Darksplat/solar-rainwater-tank-monitor/hardware/pcb/README.md

# PCB release hold

No valid complete schematic, layout, Gerber, drill, CPL or board 3D file exists in this revision. Directories reserve the requested structure. Do not mistake their presence for deliverables.

KiCad CLI 10.0.3 is installed. Live IPC was unavailable. This does not itself prevent offline design; current blockers are incomplete protected input/power design, final component qualification and footprint verification. Do not export an outline-only board and claim it is manufacturable.

Next: select protected receiver and power converters, obtain sensor order drawing, assign every pin/net, complete loop and power fault analysis, create manufacturer-backed symbol/footprint library, draw schematic, run ERC, route layout with antenna keepout, run DRC/unconnected checks, then export fabrication and assembly package and prototype.
