Darksplat/solar-rainwater-tank-monitor/releases/0.1.0-dev/README.md

**HISTORICAL: incompatible with revision0.2 INA228 hardware. Do not deploy these images on the new board.**

# 0.1.0-dev compilation fixtures

DO NOT DEPLOY: these binaries contain public test API keys and a public example Thread dataset. They prove device compilation only. Rebuild from source using independent private credentials and the reviewed production hardware design. No physical hardware testing has been performed.

Hashes and compiler evidence: ../../tests/test-results/build-summary.json. Development source revision and hosted test evidence are recorded in docs/publication-validation.md. The local v0.1.0-dev tag has not been published to GitHub.
