Darksplat/solar-rainwater-tank-monitor/docs/project-overview.md

# Architecture and engineering boundaries

Each of two identical nodes has its own panel, controller, protected 4S LiFePO4 pack and fused load feed. Neither node supplies the other. Preferred radio is ESP32-C6 Thread MTD with 5 s polling; the design does not credit unmeasured processor sleep savings. Thread transports the ESPHome native API, not Matter.

Two series 20 W panels feed a SmartSolar 75/10 through a reverse-blocking diode and 20 mΩ PV shunt. The PV return remains separate from battery negative externally. A fused 20 Ah LiFePO4 battery connects through back-to-back reverse-protection MOSFETs and a 10 mΩ battery shunt to the charger and Smart BatteryProtect input. BatteryProtect OUT powers the custom PCB; charger LOAD terminals are unused. The buck supplies 3.3 V to ESP32-C6-MINI-1 and three INA228 monitors. A switched boost supplies nominal 17.2 V to the pressure loop through a 2 Ω measurement shunt and two 110 Ω limiting resistors.

Battery percentage uses signed hardware charge accumulation after an explicit verified-full reference. It becomes unavailable after reboot, invalid samples, counter reset or capacity change; voltage alone is never treated as LiFePO4 SOC. Solar panel voltage/current/power and net battery current distinguish generation from charging. Unknown readings remain unknown.

Tank geometry inputs: length, width, usable depth, diaphragm elevation, rated capacity and maximum operating level (floor datum). Usable depth must not exceed operating level. Usable volume means water above the configured unusable bottom layer. Also report total contained water separately when calibrated. Pressure cannot resolve water below the diaphragm; mark this blind region rather than inventing a depth. Manufacturer method uses verified total volume at a measured reference depth, never the unverified 10,000 L label.

The owner's Kingspan catalogue tank is 4.0 m long, 1.15 m wide and 2.32 m high; the original 4 m height assumption is superseded. Internal rounded geometry, outlet and diaphragm datums and actual maximum fill remain unverified. Firmware uses a configurable pressure span (40 kPa default), rounded-rectangle geometry or verified volume/reference-depth calibration; calibration remains disabled until measurements are entered. Both tanks supply the garden and one also provides fire water. The owner requests no minimum-reserve display. Preserve the existing Raspberry Pi Zero2W/PoE/Sonoff Thread border router. See site-configuration.md for provenance and provisional settings. Do not drill the tank.
