Darksplat/solar-rainwater-tank-monitor/hardware/pcb/layout/render/tank-monitor-bottom.png

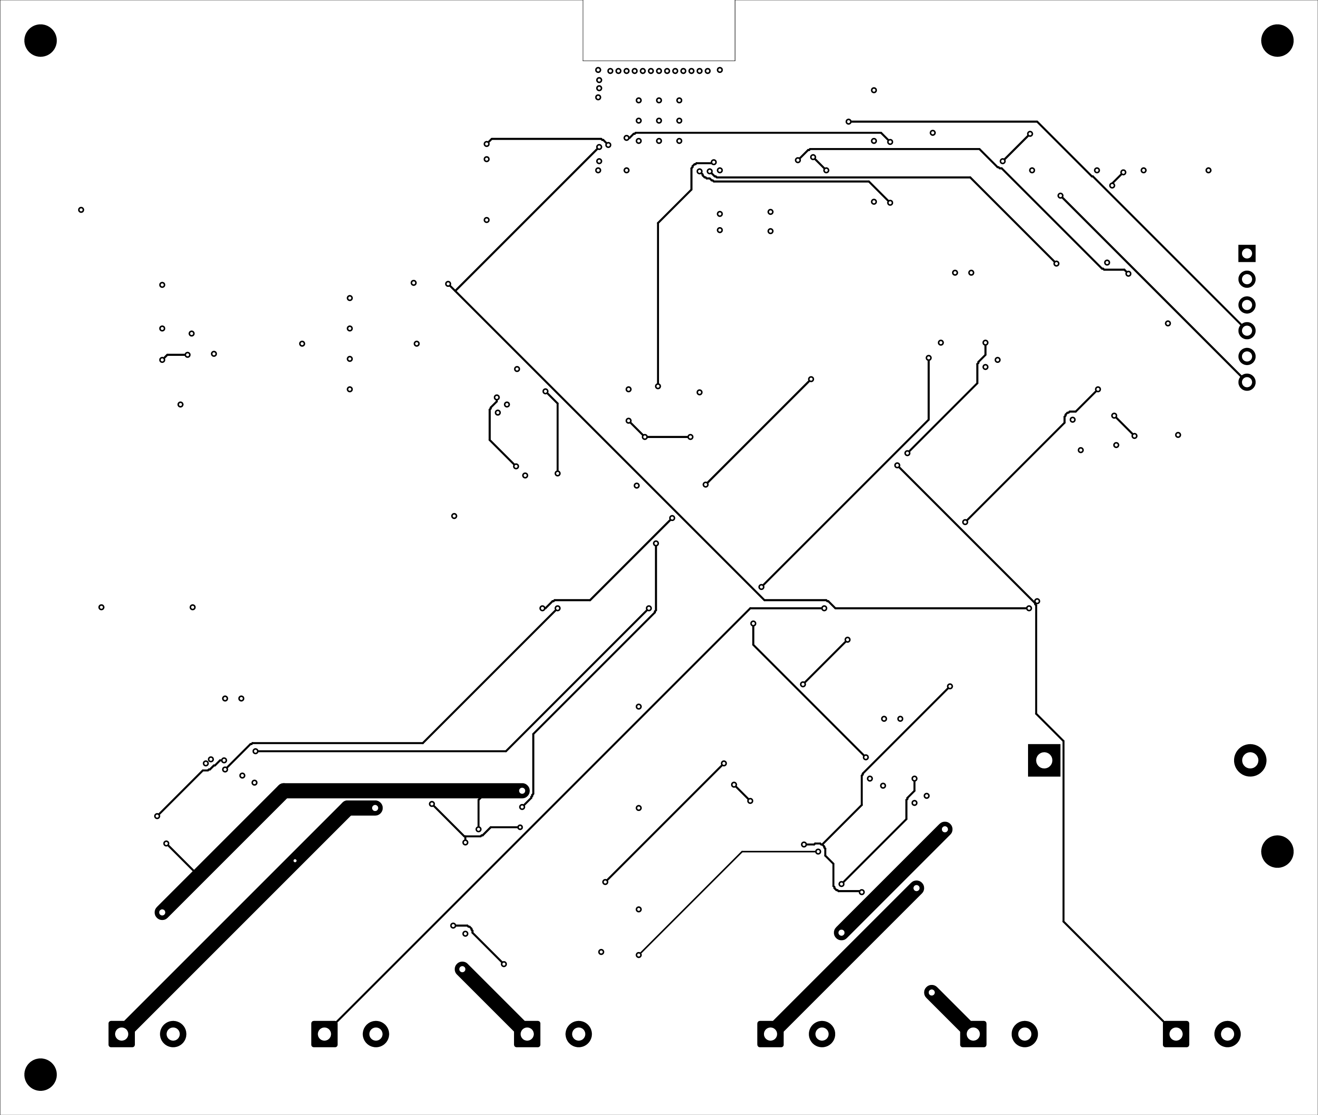
hardware/pcb/layout/render/tank-monitor-bottom.png
