Darksplat/solar-rainwater-tank-monitor/hardware/pcb/layout/render/tank-monitor-top.png

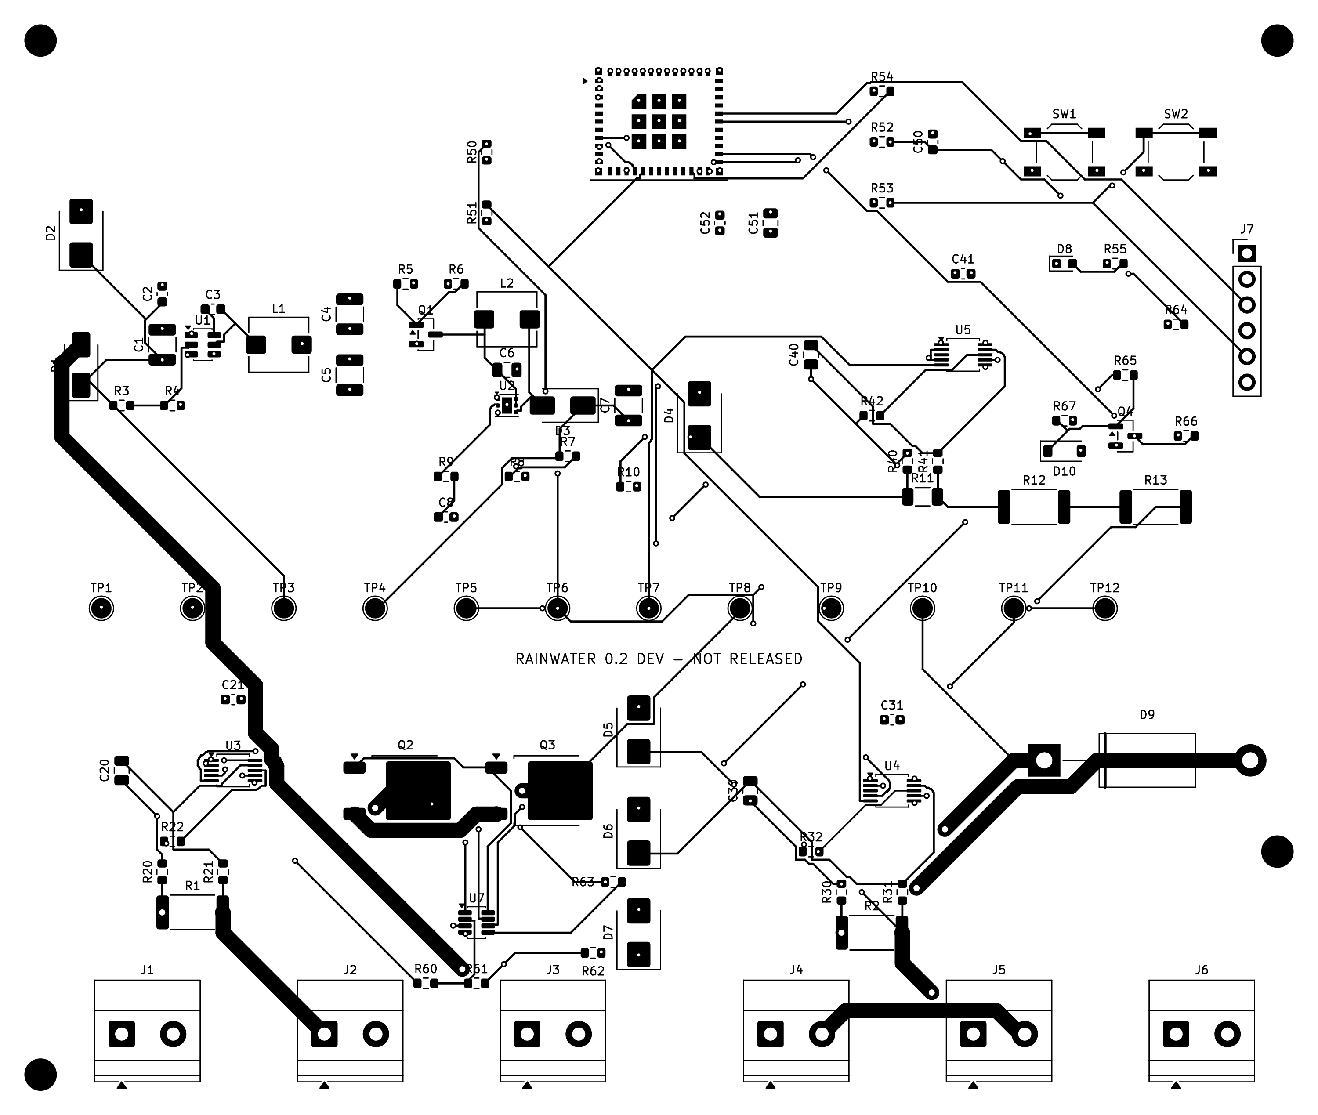
hardware/pcb/layout/render/tank-monitor-top.png
