Darksplat/solar-rainwater-tank-monitor/hardware/pcb/schematic/render/tank-monitor.png

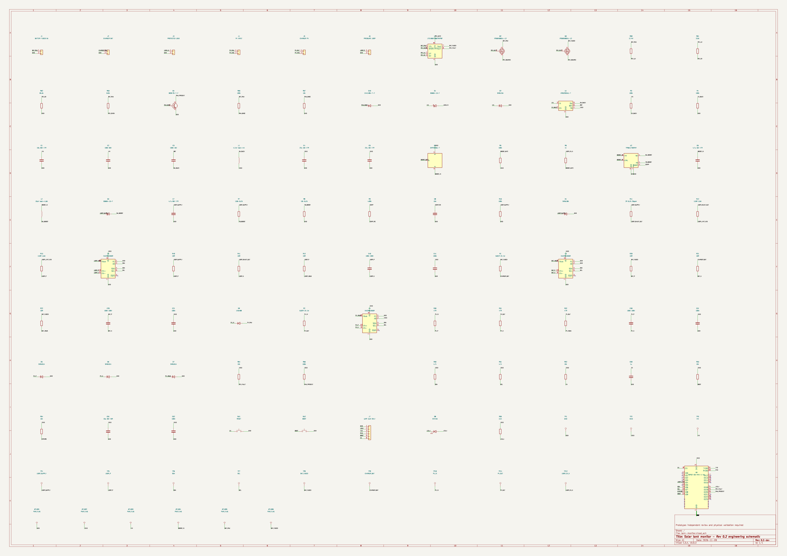
hardware/pcb/schematic/render/tank-monitor.png
