Darksplat/solar-rainwater-tank-monitor/hardware/wiring/architecture.png

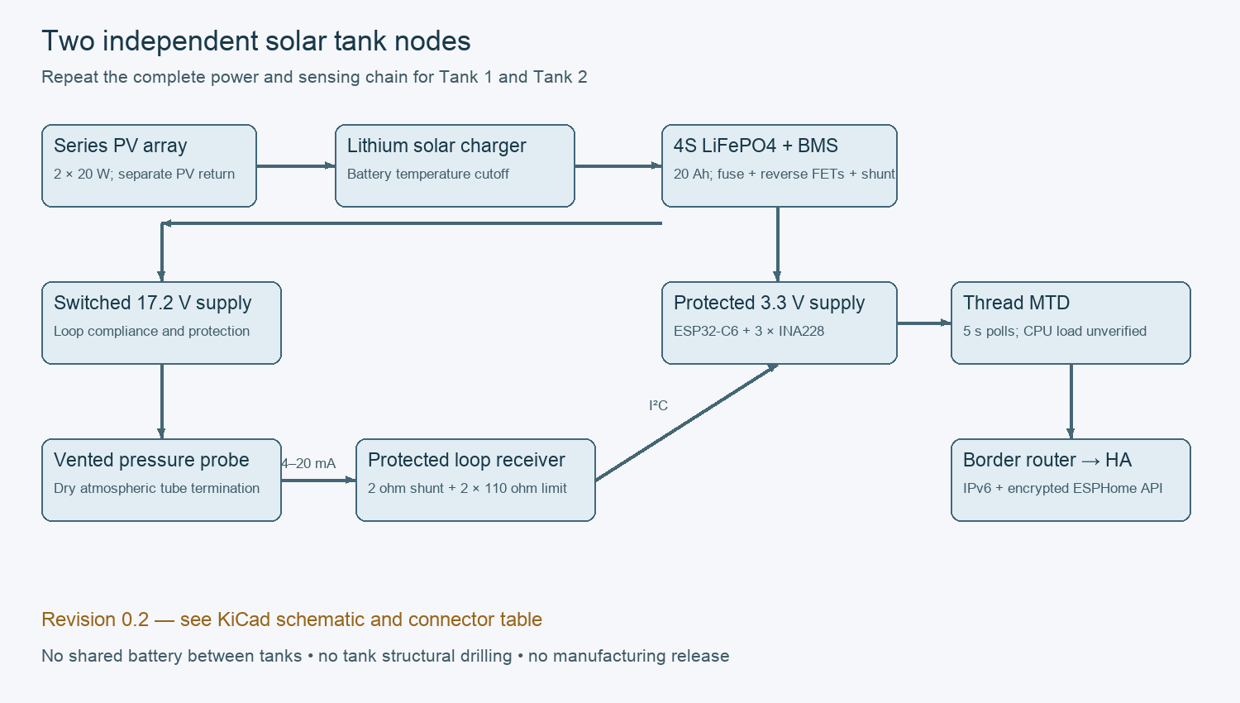
hardware/wiring/architecture.png
