Darksplat/solar-rainwater-tank-monitor/bom/australian-suppliers.md

# Australian procurement status — 9 November 2026

`master-bom.csv` consolidates two boards and two independent power/enclosure systems. PCB quantities aggregate exact candidate MPNs; test points are copper features and not purchases. The consolidated list is **not an order-ready priced quotation**. Blank product URLs/prices explicitly mean no verified direct supplier offer was obtained; they are never invented.

`supplier-lookups-v02.json` preserves dated exact-MPN distributor URLs and cached quantity-one AUD prices/stock where surfaced, now merged into the master list. The 73-line list has 40 unpriced lines. The priced-line subtotal is $549.26 for two units, combining differently stated tax bases; it is not a tax-normalised quote or project total. It includes four discontinued SPM040201200 panels at $51.95 inc GST and two BatteryProtect units at $102.30 listed RRP (confirm GST). Shipping, probes, batteries, cabinets, fabrication/assembly and many parts remain unpriced. Zero cached stock and missing direct offers remain visible. No checkout or shipping address was submitted. Custom boards do not also require historical prototype DevKits.

Obtain the exact LH-10 configured 0–0.4 bar order code, cable dimensions/material, current drawing, pressure/temperature error and applicable water-contact approval from WIKA Australia. Confirm BAT512020705 BMS version and independent low-temperature charge inhibit in writing; do not substitute an NG battery datasheet. Confirm remaining 20 W panel stock before freezing the design. The current 30 W replacement needs PV surge-protection redesign.

Buy PCB parts from authorized DigiKey Australia, Mouser Australia or element14 channels using the exact MPN list; their automated cross-substitution suggestions are not engineering approval. Manufacturer records for fifteen resistor candidates were retrieved automatically; TDK blocked that downloader, while several capacitor records were verified through browser-accessible manufacturer pages. `manufacturer-record-check.json` records retrieval limitations separately from electrical qualification. Remaining DC-bias, stencil and thermal checks are release gates, not passed tests.

The cabinet is listed by RS Australia under 2880946. Primary Fibox specifications take precedence over distributor text: ARCA403021S is currently listed IP65 by the manufacturer. Pole kit, glands and pressure vent are identified but need Australian quotes and final cable/installation dimensions. Commodity fasteners, cable cut lengths, ferrules, brackets and restraints must be finalized from the dry-fit drawing and site survey.
