Darksplat/solar-rainwater-tank-monitor/bom/master-bom.csv

stage | manufacturer | part_number | references | quantity_two_units | supplier | product_url | unit_price_AUD | price_basis | availability_observed | datasheet_url | alternative | status
rev0.2 PCB candidate | Diodes Incorporated | 1N4148W-7-F | D10 | 2 | DigiKey AU | https://www.digikey.com.au/en/products/detail/diodes-incorporated/1N4148W-7-F/815280 | 0.26000 | Cached exact-MPN supplier result; quantity-one price where shown; GST/checkout reconfirmation required | 1,271,200 | https://www.diodes.com/datasheet/download/1N4148W.pdf | same footprint/rating only after engineering review | nominal selection; exact stock, DC bias and assembly qualification gates apply
rev0.2 PCB candidate | Vishay | 1N5408-E3/54 | D9 | 2 | DigiKey AU | https://www.digikey.com.au/en/products/detail/vishay-general-semiconductor-diodes-division/1N5408-E3-54/190152 |  | Cached exact-MPN supplier result; quantity-one price where shown; GST/checkout reconfirmation required | not verified | https://www.vishay.com/docs/88516/1n5400.pdf | same footprint/rating only after engineering review | nominal selection; exact stock, DC bias and assembly qualification gates apply
rev0.2 PCB candidate | Diodes Incorporated | AP63203WU-7 | U1 | 2 | DigiKey AU | https://www.digikey.com.au/en/products/detail/diodes-incorporated/AP63203WU-7/9858430 | 1.30000 | Cached supplier result, quantity-one list price; GST and checkout confirmation required | 0 | https://www.diodes.com/datasheet/download/AP63200-AP63201-AP63203-AP63205.pdf | same footprint/rating only after engineering review | nominal selection; exact stock, DC bias and assembly qualification gates apply
rev0.2 PCB candidate | Diodes Incorporated | B360A-13-F | D1 D3 | 4 | DigiKey AU | https://www.digikey.com.au/en/products/detail/diodes-incorporated/B360A-13-F/724980 | 0.80000 | Cached supplier result, quantity-one list price; GST and checkout confirmation required | 26,358 | https://www.diodes.com/datasheet/download/B360A.pdf | same footprint/rating only after engineering review | nominal selection; exact stock, DC bias and assembly qualification gates apply
rev0.2 PCB candidate | Diodes Incorporated | BC847B-7-F | Q4 | 2 | DigiKey AU | https://www.digikey.com.au/en/products/detail/diodes-incorporated/BC847B-7-F/2181060 |  | Cached exact-MPN supplier result; quantity-one price where shown; GST/checkout reconfirmation required | not verified | https://www.diodes.com/datasheet/download/BC847B.pdf | same footprint/rating only after engineering review | nominal selection; exact stock, DC bias and assembly qualification gates apply
rev0.2 PCB candidate | TDK | C1608X7R1C105K080AC | C50 | 2 | DigiKey AU | https://www.digikey.com.au/en/products/detail/tdk/C1608X7R1C105K080AC/634399 | 0.18000 | Cached supplier result, quantity-one list price; GST and checkout confirmation required | 839,037 | https://product.tdk.com/en/search/capacitor/ceramic/mlcc/info?part_no=C1608X7R1C105K080AC | same footprint/rating only after engineering review | nominal selection; exact stock, DC bias and assembly qualification gates apply
rev0.2 PCB candidate | TDK | C1608X7R1H103K080AA | C8 | 2 | DigiKey AU | https://www.digikey.com.au/en/products/detail/tdk/C1608X7R1H103K080AA/513809 | 0.15000 | Cached supplier result, quantity-one list price; GST and checkout confirmation required | 456,678 | https://product.tdk.com/en/search/capacitor/ceramic/mlcc/info?part_no=C1608X7R1H103K080AA | same footprint/rating only after engineering review | nominal selection; exact stock, DC bias and assembly qualification gates apply
rev0.2 PCB candidate | TDK | C1608X7R1H104K080AA | C2 C3 C21 C31 C41 C52 | 12 | DigiKey AU | https://www.digikey.com.au/en/products/detail/tdk/C1608X7R1H104K080AA/567687 | 0.16000 | Cached supplier result, quantity-one list price; GST and checkout confirmation required | 0 | https://product.tdk.com/en/search/capacitor/ceramic/mlcc/info?part_no=C1608X7R1H104K080AA | same footprint/rating only after engineering review | nominal selection; exact stock, DC bias and assembly qualification gates apply
rev0.2 PCB candidate | TDK | C2012X5R1V106K085AC | C51 | 2 | DigiKey AU | https://www.digikey.com.au/en/products/detail/tdk/C2012X5R1V106K085AC/3951653 | 0.70000 | Cached supplier result, quantity-one list price; GST and checkout confirmation required | 893 | https://product.tdk.com/en/search/capacitor/ceramic/mlcc/info?part_no=C2012X5R1V106K085AC | same footprint/rating only after engineering review | nominal selection; exact stock, DC bias and assembly qualification gates apply
rev0.2 PCB candidate | TDK | C2012X7R1C475K125AB | C6 | 2 | DigiKey AU | https://www.digikey.com.au/en/products/detail/tdk/C2012X7R1C475K125AB/2619200 | 0.44000 | Cached supplier result, quantity-one list price; GST and checkout confirmation required | 100,246 | https://product.tdk.com/en/search/capacitor/ceramic/mlcc/info?part_no=C2012X7R1C475K125AB | same footprint/rating only after engineering review | nominal selection; exact stock, DC bias and assembly qualification gates apply
rev0.2 PCB candidate | TDK | C2012X7R2A104K125AA | C20 C30 C40 | 6 | DigiKey AU | https://www.digikey.com.au/en/products/detail/tdk/C2012X7R2A104K125AA/569044 | 0.25000 | Cached supplier result, quantity-one list price; GST and checkout confirmation required | 383,512 | https://product.tdk.com/en/search/capacitor/ceramic/mlcc/info?part_no=C2012X7R2A104K125AA | same footprint/rating only after engineering review | nominal selection; exact stock, DC bias and assembly qualification gates apply
rev0.2 PCB candidate | TDK | C3225X7R1C226M250AC | C4 C5 | 4 | DigiKey AU | https://www.digikey.com.au/en/products/detail/tdk/C3225X7R1C226M250AC/1944442 | 0.90000 | Cached supplier result, quantity-one list price; GST and checkout confirmation required | 0 | https://product.tdk.com/en/search/capacitor/ceramic/mlcc/info?part_no=C3225X7R1C226M250AC | same footprint/rating only after engineering review | nominal selection; exact stock, DC bias and assembly qualification gates apply
rev0.2 PCB candidate | TDK | C3225X7R1H106K250AC | C1 | 2 | DigiKey AU | https://www.digikey.com.au/en/products/detail/tdk/C3225X7R1H106K250AC/10415006 | 1.51000 | Cached supplier result, quantity-one list price; GST and checkout confirmation required | 181 | https://product.tdk.com/en/search/capacitor/ceramic/mlcc/info?part_no=C3225X7R1H106K250AC | same footprint/rating only after engineering review | nominal selection; exact stock, DC bias and assembly qualification gates apply
rev0.2 PCB candidate | TDK | C3225X7R1H475K250AB | C7 | 2 | DigiKey AU | https://www.digikey.com.au/en/products/detail/tdk/C3225X7R1H475K250AB/2733161 | 1.15000 | Cached supplier result, quantity-one list price; GST and checkout confirmation required | 23,246 | https://product.tdk.com/en/search/capacitor/ceramic/mlcc/info?part_no=C3225X7R1H475K250AB | same footprint/rating only after engineering review | nominal selection; exact stock, DC bias and assembly qualification gates apply
rev0.2 PCB candidate | Vishay | CRCW2512110RFKEGHP | R12 R13 | 4 | DigiKey international; AU quote required | https://www.digikey.com/en/products/detail/vishay-dale/CRCW2512110RFKEGHP/2201305 |  | Cached supplier result, quantity-one list price; GST and checkout confirmation required | not confirmed | https://www.vishay.com/docs/20115/crcwhp.pdf | same footprint/rating only after engineering review | nominal selection; exact stock, DC bias and assembly qualification gates apply
rev0.2 PCB candidate | Diodes Incorporated | DMP2035U-7 | Q1 | 2 | DigiKey AU | https://www.digikey.com.au/en/products/detail/diodes-incorporated/DMP2035U-7/2181234 |  | Cached supplier result, quantity-one list price; GST and checkout confirmation required | not confirmed | https://www.diodes.com/datasheet/download/DMP2035U.pdf | same footprint/rating only after engineering review | nominal selection; exact stock, DC bias and assembly qualification gates apply
rev0.2 PCB candidate | Espressif | ESP32-C6-MINI-1-N4 | U6 | 2 | DigiKey AU | https://www.digikey.com.au/en/products/detail/espressif-systems/ESP32-C6-MINI-1-N4/17885796 | 6.60000 | Cached supplier result, quantity-one list price; GST and checkout confirmation required | 199 | https://www.espressif.com/sites/default/files/documentation/esp32-c6-mini-1_mini-1u_datasheet_en.pdf | same footprint/rating only after engineering review | nominal selection; exact stock, DC bias and assembly qualification gates apply
rev0.2 PCB candidate | Texas Instruments | INA228AIDGSR | U3 U4 U5 | 6 | DigiKey AU | https://www.digikey.com.au/en/products/detail/texas-instruments/INA228AIDGSR/13691078 | 7.73000 | Cached supplier result, quantity-one list price; GST and checkout confirmation required | 0 | https://www.ti.com/lit/ds/symlink/ina228.pdf | same footprint/rating only after engineering review | nominal selection; exact stock, DC bias and assembly qualification gates apply
rev0.2 PCB candidate | Infineon | IPD50N06S4L12ATMA2 | Q2 Q3 | 4 | DigiKey AU | https://www.digikey.com.au/en/products/detail/infineon-technologies/IPD50N06S4L12ATMA2/6108992 |  | Cached exact-MPN supplier result; quantity-one price where shown; GST/checkout reconfirmation required | 23,753 | https://www.infineon.com/part/IPD50N06S4L-12 | same footprint/rating only after engineering review | nominal selection; exact stock, DC bias and assembly qualification gates apply
rev0.2 PCB candidate | Analog Devices | LTC4365ITS8#TRMPBF | U7 | 2 | DigiKey AU | https://www.digikey.com.au/en/products/detail/analog-devices-inc/LTC4365ITS8-TRMPBF/2405924 |  | Cached exact-MPN supplier result; quantity-one price where shown; GST/checkout reconfirmation required | not verified | https://www.analog.com/media/en/technical-documentation/data-sheets/4365fa.pdf | same footprint/rating only after engineering review | nominal selection; exact stock, DC bias and assembly qualification gates apply
rev0.2 PCB candidate | Lite-On | LTST-C190KGKT | D8 | 2 | DigiKey AU | https://www.digikey.com.au/en/products/detail/lite-on-inc/LTST-C190KGKT/386815 |  | Cached supplier result, quantity-one list price; GST and checkout confirmation required | not confirmed |  | same footprint/rating only after engineering review | nominal selection; exact stock, DC bias and assembly qualification gates apply
rev0.2 PCB candidate | Phoenix Contact | Phoenix 1715721 | J1 J2 J3 J4 J5 J6 | 12 | DigiKey AU | https://www.digikey.com.au/en/products/detail/phoenix-contact/1715721/260631 | 1.69000 | Cached supplier result, quantity-one list price; GST and checkout confirmation required | 1,212 | https://www.phoenixcontact.com/en-pc/products/pcb-terminal-block-mkds-15-2-508-1715721 | same footprint/rating only after engineering review | nominal selection; exact stock, DC bias and assembly qualification gates apply
rev0.2 PCB candidate | Yageo | RC0603FR-07100KL | R65 R66 R3 R4 R5 R10 | 12 | DigiKey AU | https://www.digikey.com.au/en/products/detail/yageo/RC0603FR-07100KL/729836 |  | Cached supplier result, quantity-one list price; GST and checkout confirmation required | not confirmed | https://www.yageogroup.com/component-documentation/download/specsheet/RC0603FR-07100KL | same footprint/rating only after engineering review | nominal selection; exact stock, DC bias and assembly qualification gates apply
rev0.2 PCB candidate | Yageo | RC0603FR-0710KL | R64 R67 R52 R53 R54 | 10 | DigiKey AU | https://www.digikey.com.au/en/products/detail/yageo/RC0603FR-0710KL/726880 | 0.15000 | Cached supplier result, quantity-one list price; GST and checkout confirmation required | 2,633,738 | https://www.yageogroup.com/component-documentation/download/specsheet/RC0603FR-0710KL | same footprint/rating only after engineering review | nominal selection; exact stock, DC bias and assembly qualification gates apply
rev0.2 PCB candidate | Yageo | RC0603FR-0710RL | R20 R21 R22 R40 R41 R42 | 12 | DigiKey AU | https://www.digikey.com.au/en/products/detail/yageo/RC0603FR-0710RL/726879 | 0.15000 | Cached supplier result, quantity-one list price; GST and checkout confirmation required | 0 | https://www.yageogroup.com/component-documentation/download/specsheet/RC0603FR-0710RL | same footprint/rating only after engineering review | nominal selection; exact stock, DC bias and assembly qualification gates apply
rev0.2 PCB candidate | Yageo | RC0603FR-071KL | R6 | 2 | DigiKey AU | https://www.digikey.com.au/en/products/detail/yageo/RC0603FR-071KL/729790 |  | Cached supplier result, quantity-one list price; GST and checkout confirmation required | not confirmed | https://www.yageogroup.com/component-documentation/download/specsheet/RC0603FR-071KL | same footprint/rating only after engineering review | nominal selection; exact stock, DC bias and assembly qualification gates apply
rev0.2 PCB candidate | Yageo | RC0603FR-07215KL | R61 | 2 | DigiKey AU / Mouser AU / element14 quote |  |  | quote required; not estimated | not independently confirmed at checkout | https://www.yageogroup.com/component-documentation/download/specsheet/RC0603FR-07215KL | same footprint/rating only after engineering review | nominal selection; exact stock, DC bias and assembly qualification gates apply
rev0.2 PCB candidate | Yageo | RC0603FR-072K2L | R55 | 2 | DigiKey AU | https://www.digikey.com.au/en/products/detail/yageo/RC0603FR-072K2L/729963 | 0.15000 | Cached supplier result, quantity-one list price; GST and checkout confirmation required | 64,639 | https://www.yageogroup.com/component-documentation/download/specsheet/RC0603FR-072K2L | same footprint/rating only after engineering review | nominal selection; exact stock, DC bias and assembly qualification gates apply
rev0.2 PCB candidate | Yageo | RC0603FR-072M74L | R60 | 2 | DigiKey AU / Mouser AU / element14 quote |  |  | quote required; not estimated | not independently confirmed at checkout | https://www.yageogroup.com/component-documentation/download/specsheet/RC0603FR-072M74L | same footprint/rating only after engineering review | nominal selection; exact stock, DC bias and assembly qualification gates apply
rev0.2 PCB candidate | Yageo | RC0603FR-0747RL | R30 R31 R32 | 6 | DigiKey AU | https://www.digikey.com.au/en/products/detail/yageo/RC0603FR-0747RL/730199 | 0.15000 | Cached supplier result, quantity-one list price; GST and checkout confirmation required | 321,975 | https://www.yageogroup.com/component-documentation/download/specsheet/RC0603FR-0747RL | same footprint/rating only after engineering review | nominal selection; exact stock, DC bias and assembly qualification gates apply
rev0.2 PCB candidate | Yageo | RC0603FR-074K7L | R50 R51 | 4 | DigiKey AU | https://www.digikey.com.au/en/products/detail/yageo/RC0603FR-074K7L/727212 | 0.15000 | Cached supplier result, quantity-one list price; GST and checkout confirmation required | 4,484,511 | https://www.yageogroup.com/component-documentation/download/specsheet/RC0603FR-074K7L | same footprint/rating only after engineering review | nominal selection; exact stock, DC bias and assembly qualification gates apply
rev0.2 PCB candidate | Yageo | RC0603FR-074K99L | R9 | 2 | DigiKey AU | https://www.digikey.com.au/en/products/detail/yageo/RC0603FR-074K99L/730166 | 0.15000 | Cached supplier result, quantity-one list price; GST and checkout confirmation required | 80,845 | https://www.yageogroup.com/component-documentation/download/specsheet/RC0603FR-074K99L | same footprint/rating only after engineering review | nominal selection; exact stock, DC bias and assembly qualification gates apply
rev0.2 PCB candidate | Yageo | RC0603FR-07510KL | R63 | 2 | DigiKey AU / Mouser AU / element14 quote |  |  | quote required; not estimated | not independently confirmed at checkout | https://www.yageogroup.com/component-documentation/download/specsheet/RC0603FR-07510KL | same footprint/rating only after engineering review | nominal selection; exact stock, DC bias and assembly qualification gates apply
rev0.2 PCB candidate | Yageo | RC0603FR-0784K5L | R62 | 2 | DigiKey AU | https://www.digikey.com.au/en/products/detail/yageo/RC0603FR-0784K5L/727408 |  | Cached exact-MPN supplier result; quantity-one price where shown; GST/checkout reconfirmation required | not verified | https://www.yageogroup.com/component-documentation/download/specsheet/RC0603FR-0784K5L | same footprint/rating only after engineering review | nominal selection; exact stock, DC bias and assembly qualification gates apply
rev0.2 PCB candidate | Yageo | RT0603BRD0710KL | R8 | 2 | DigiKey AU | https://www.digikey.com.au/en/products/detail/yageo/RT0603BRD0710KL/1072198 | 0.15000 | Cached supplier result, quantity-one list price; GST and checkout confirmation required | 248,686 | https://www.yageogroup.com/component-documentation/download/specsheet/RT0603BRD0710KL | same footprint/rating only after engineering review | nominal selection; exact stock, DC bias and assembly qualification gates apply
rev0.2 PCB candidate | Yageo | RT0603BRD07130KL | R7 | 2 | DigiKey AU / Mouser AU / element14 quote |  |  | quote required; not estimated | not independently confirmed at checkout | https://www.yageogroup.com/component-documentation/download/specsheet/RT0603BRD07130KL | same footprint/rating only after engineering review | nominal selection; exact stock, DC bias and assembly qualification gates apply
rev0.2 PCB candidate | Yageo | RT1206BRD072RL | R11 | 2 | DigiKey international; AU quote required | https://www.digikey.com/en/products/detail/yageo/RT1206BRD072RL/17020542 |  | Cached supplier result, quantity-one list price; GST and checkout confirmation required | not confirmed | https://www.yageogroup.com/component-documentation/download/specsheet/RT1206BRD072RL | same footprint/rating only after engineering review | nominal selection; exact stock, DC bias and assembly qualification gates apply
rev0.2 PCB candidate | Littelfuse | SMBJ15A | D2 | 2 | DigiKey AU | https://www.digikey.com.au/en/products/detail/littelfuse-inc/SMBJ15A/285980 |  | Cached supplier result, quantity-one list price; GST and checkout confirmation required | not confirmed | https://www.littelfuse.com/assetdocs/littelfuse-tvs-diode-smbj-datasheet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 | same footprint/rating only after engineering review | nominal selection; exact stock, DC bias and assembly qualification gates apply
rev0.2 PCB candidate | Littelfuse | SMBJ18A | D4 | 2 | DigiKey AU | https://www.digikey.com.au/en/products/detail/littelfuse-inc/SMBJ18A/285984 |  | Cached supplier result, quantity-one list price; GST and checkout confirmation required | 14,250 |  | same footprint/rating only after engineering review | nominal selection; exact stock, DC bias and assembly qualification gates apply
rev0.2 PCB candidate | Littelfuse | SMBJ51A | D5 D6 D7 | 6 | DigiKey international; AU quote required | https://www.digikey.com/en/products/detail/littelfuse-inc/SMBJ51A/762800 |  | Verified exact Littelfuse global product record; Australian quote required | AU stock/price not confirmed |  | same footprint/rating only after engineering review | nominal selection; exact stock, DC bias and assembly qualification gates apply
rev0.2 PCB candidate | Bourns | SRP5030TA-100M | L2 | 2 | DigiKey AU | https://www.digikey.com.au/en/products/detail/bourns-inc/SRP5030TA-100M/5429753 | 1.54000 | Cached supplier result, quantity-one list price; GST and checkout confirmation required | 966 | https://www.bourns.com/docs/product-datasheets/srp5030ta.pdf?sfvrsn=f08a91f1_28 | same footprint/rating only after engineering review | nominal selection; exact stock, DC bias and assembly qualification gates apply
rev0.2 PCB candidate | Bourns | SRP5030TA-4R7M | L1 | 2 | DigiKey AU | https://www.digikey.com.au/en/products/detail/bourns-inc/SRP5030TA-4R7M/5429759 | 1.51000 | Cached supplier result, quantity-one list price; GST and checkout confirmation required | 178 | https://www.bourns.com/docs/product-datasheets/srp5030ta.pdf?sfvrsn=f08a91f1_28 | same footprint/rating only after engineering review | nominal selection; exact stock, DC bias and assembly qualification gates apply
rev0.2 PCB candidate | E-Switch | TL3342F160QG-TR | SW1 SW2 | 4 | DigiKey AU | https://www.digikey.com.au/en/products/detail/e-switch/TL3342F160QG-TR/379004 | 0.86000 | Cached supplier result, quantity-one list price; GST and checkout confirmation required | 5,953 |  | same footprint/rating only after engineering review | nominal selection; exact stock, DC bias and assembly qualification gates apply
rev0.2 PCB candidate | Texas Instruments | TPS61170DRVR | U2 | 2 | DigiKey AU | https://www.digikey.com.au/en/products/detail/texas-instruments/TPS61170DRVR/1769603 | 3.71000 | Cached supplier result, quantity-one list price; GST and checkout confirmation required | 0 | https://www.ti.com/lit/ds/symlink/tps61170.pdf | same footprint/rating only after engineering review | nominal selection; exact stock, DC bias and assembly qualification gates apply
rev0.2 PCB candidate | Samtec | TSW-106-07-G-S | J7 | 2 | DigiKey AU | https://www.digikey.com.au/en/products/detail/samtec-inc/TSW-106-07-G-S/1101321 | 0.84000 | Cached supplier result, quantity-one list price; GST and checkout confirmation required | 3,290 | https://www.samtec.com/products/tsw-106-07-g-s | same footprint/rating only after engineering review | nominal selection; exact stock, DC bias and assembly qualification gates apply
rev0.2 PCB candidate | Vishay | WSL2512R0100FEA | R1 | 2 | DigiKey AU | https://www.digikey.com.au/en/products/detail/vishay-dale/WSL2512R0100FEA/713493 | 0.92000 | Cached supplier result, quantity-one list price; GST and checkout confirmation required | 280,085 |  | same footprint/rating only after engineering review | nominal selection; exact stock, DC bias and assembly qualification gates apply
rev0.2 PCB candidate | Vishay | WSL2512R0200FEA | R2 | 2 | DigiKey AU | https://www.digikey.com.au/en/products/detail/vishay-dale/WSL2512R0200FEA/712563 | 0.97000 | Cached supplier result, quantity-one list price; GST and checkout confirmation required | 88,279 |  | same footprint/rating only after engineering review | nominal selection; exact stock, DC bias and assembly qualification gates apply
rev0.2 external | WIKA | LH-10 0–0.4bar 4–20mA vented PUR 10m |  | 2 | WIKA Australia | https://www.wika.com/en-au/lh_10.WIKA |  | quote required | reconfirm before purchase | https://www.wika.com/media/Data-sheets/Level/Submersible-pressure-sensors/ds_pe8109_en_co.pdf | engineering review required | configured order code, current drawing and water-contact suitability require quote
rev0.2 external | Victron | SPM040201200 |  | 4 | Every Battery | https://www.everybattery.com.au/product/spm040201200-victron-solar-panel-20w-12v-mono-440x350x25mm-series-4a/ | 51.95 | listed inc GST 2026-11-09 | reconfirm before purchase | https://www.victronenergy.com/upload/documents/Datasheet-BlueSolar-Monocrystalline-Panels-EN.pdf | 30W current model NOT drop-in: PV protection redesign | discontinued; listed remaining stock must be secured before final release
rev0.2 external | Victron | BAT512020705 |  | 2 | Batteries Direct | https://batteriesdirect.com.au/shop/product/35244/lfp-lsp12.8/20.html |  | quote required | reconfirm before purchase |  | engineering review required | exact BMS version and low-temperature charge cutoff require written confirmation
rev0.2 external | Victron | SmartSolar MPPT 75/10 |  | 2 | Australian Victron distributor |  |  | quote required | reconfirm before purchase | https://www.victronenergy.com/media/pg/Manual_SmartSolar_MPPT_75-10_up_to_100-20/en/index.html | engineering review required | selected for model; quote/stock required
rev0.2 external | Victron | BPR065022000 |  | 2 | Baintech stockist | https://baintech.com.au/product/victron-smart-battery-protect-12-24v-65a/ | 102.3 | listed RRP; GST basis confirm | reconfirm before purchase | https://www.victronenergy.com/upload/documents/Smart_BatteryProtect_12V_24V/114439-Smart_BatteryProtect-pdf-en.pdf | engineering review required | 7 listed; configure voltage mode A, not BMS-only mode C
rev0.2 external | Fibox | 8120087 ARCA403021S |  | 2 | RS Australia | https://au.rs-online.com/web/p/general-purpose-enclosures/2880946 |  | quote required | reconfirm before purchase | https://www.fibox.com/products/ARCA-IEC/ARCA-403021/8120087 | engineering review required | manufacturer currently specifies IP65; assembled system unrated
rev0.2 external | Fibox | 8120841 PMK ARCA30 |  | 2 | Fibox Australian distributor |  |  | quote required | reconfirm before purchase | https://www.fibox.com/products/ARCA-IEC/ARCA-403021/8120087 | engineering review required | selected proprietary pole kit, supports 100–300mm diameter; site pole/footing review
rev0.2 external | Hummel | 1.209.1600.50 HSK-K M16 4–8mm |  | 4 | Australian industrial distributor quote |  |  | quote required | reconfirm before purchase | https://www.hummel.com/en/cable-glands/products/plastic-cable-glands/hsk-k/ | engineering review required | candidate two PV single-cable glands per cabinet; actual cable OD and UV formulation confirmation
rev0.2 external | Hummel | 1.209.2000.50 HSK-K M20 6–12mm |  | 2 | Australian industrial distributor quote |  |  | quote required | reconfirm before purchase | https://www.hummel.com/en/cable-glands/products/plastic-cable-glands/hsk-k/ | engineering review required | probe gland candidate; actual cable OD and formulation must match
rev0.2 external | Bopla | 52041000 DAE M12 |  | 2 | Australian Bopla distributor quote |  |  | quote required | reconfirm before purchase | https://www.bopla.de/en/enclosure-technology/cable-glands-general-accessories/pressure-compensation-elements | engineering review required | pressure vent candidate; current dimensions and mounting torque required
rev0.2 external | Littelfuse | 0FHA0001ZXJ |  | 4 | DigiKey AU / element14 quote |  |  | quote required | reconfirm before purchase | https://www.littelfuse.com/assetdocs/ato-fha-datasheet?assetguid=988addec-bfe3-4ea2-9204-e2982cbb488e | engineering review required | 5A battery and 2A protected board branch holders; 32V DC, 105C family specification
rev0.2 external | Littelfuse | 0287005.H |  | 4 | DigiKey AU | https://www.digikey.com.au/en/products/detail/littelfuse-inc/0287005-H/3104044 | 0.89000 | Cached supplier result, quantity-one list price; GST and checkout confirmation required | reconfirm before purchase |  | engineering review required | 2 installed +2 spares; 32V DC 1000A family interrupt rating must exceed actual battery prospective fault current
rev0.2 external | Littelfuse | 0287002.H |  | 4 | DigiKey AU | https://www.digikey.com.au/en/products/detail/littelfuse-inc/0287002-H/3104041 | 0.93000 | Cached supplier result, quantity-one list price; GST and checkout confirmation required | reconfirm before purchase |  | engineering review required | 2 installed +2 spares; 32V DC 1000A family interrupt rating must exceed actual battery prospective fault current
rev0.2 external | procurement specification | PV-rated DC isolator >=100V DC, >=3A, suitable switching polarity |  | 2 |  |  |  | quote required | reconfirm before purchase |  | engineering review required | exact part selection requires site enclosure/cable arrangement and supplier confirmation
rev0.2 external | procurement specification | M3 10mm standoff and M3 screws/washers kit |  | 8 |  |  |  | quote required | reconfirm before purchase |  | engineering review required | not an exact purchased part yet; close from drawings, cable survey or supplier quote
rev0.2 external | procurement specification | M5 shelf bolts and locking nuts |  | 8 |  |  |  | quote required | reconfirm before purchase |  | engineering review required | not an exact purchased part yet; close from drawings, cable survey or supplier quote
rev0.2 external | procurement specification | rated 20mm battery restraint straps with buckles |  | 4 |  |  |  | quote required | reconfirm before purchase |  | engineering review required | not an exact purchased part yet; close from drawings, cable survey or supplier quote
rev0.2 external | procurement specification | 316 stainless probe guard and independent suspension |  | 2 |  |  |  | quote required | reconfirm before purchase |  | engineering review required | not an exact purchased part yet; close from drawings, cable survey or supplier quote
rev0.2 external | procurement specification | dry atmospheric vent filter/desiccant terminal |  | 2 |  |  |  | quote required | reconfirm before purchase |  | engineering review required | not an exact purchased part yet; close from drawings, cable survey or supplier quote
rev0.2 external | procurement specification | UV solar cable and matched connectors |  | site measured length |  |  |  | quote required | reconfirm before purchase |  | engineering review required | not an exact purchased part yet; close from drawings, cable survey or supplier quote
rev0.2 external | procurement specification | 105C cabinet wire, ferrules and M5/M6 lugs |  | cut list after dry fit |  |  |  | quote required | reconfirm before purchase |  | engineering review required | not an exact purchased part yet; close from drawings, cable survey or supplier quote
rev0.2 external | procurement specification | rated positive distribution connector and mount |  | 2 |  |  |  | quote required | reconfirm before purchase |  | engineering review required | not an exact purchased part yet; close from drawings, cable survey or supplier quote
rev0.2 external | procurement specification | PCB 4-layer 130x110 1.6mm and assembly |  | 2 |  |  |  | quote required | reconfirm before purchase |  | engineering review required | not an exact purchased part yet; close from drawings, cable survey or supplier quote
rev0.2 external | procurement specification | 250x350x4 service plate and bent 2mm battery shelf |  | 2 |  |  |  | quote required | reconfirm before purchase |  | engineering review required | not an exact purchased part yet; close from drawings, cable survey or supplier quote
rev0.2 external | procurement specification | solar rail/clamp kit and site-rated post/footing |  | 2 |  |  |  | quote required | reconfirm before purchase |  | engineering review required | not an exact purchased part yet; close from drawings, cable survey or supplier quote
rev0.2 external | procurement specification | 3.3V UART programmer and calibrated bench test equipment |  | 1 |  |  |  | quote required | reconfirm before purchase |  | engineering review required | not an exact purchased part yet; close from drawings, cable survey or supplier quote
