Darksplat/solar-rainwater-tank-monitor/hardware/cad/step/TankMonitorAssembly.step

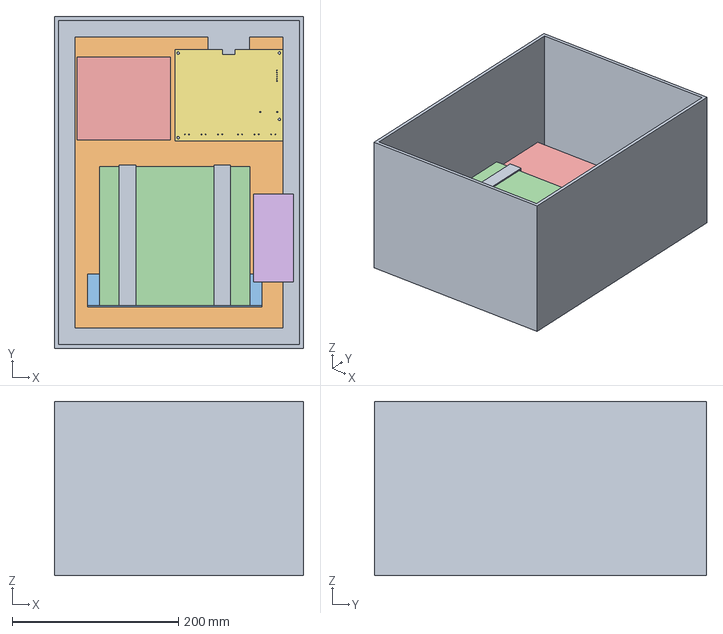
[picture p7: CAD file, 2026-11-09]
hardware/cad/step/TankMonitorAssembly.step
300.0 x 400.0 x 210.0 mm
