Darksplat/solar-rainwater-tank-monitor/hardware/cad/freecad/TankMonitorMechanical.FCStd

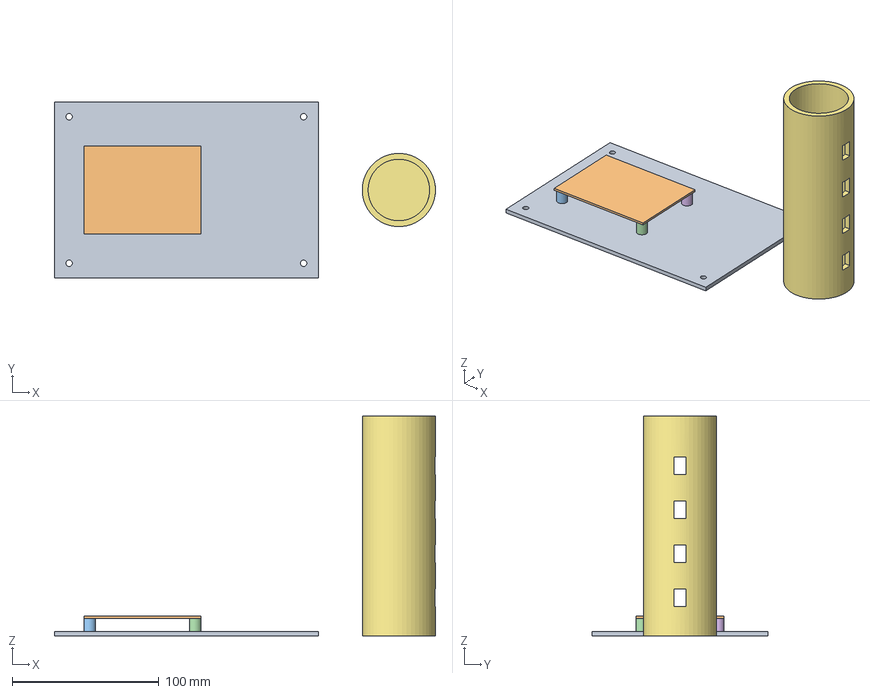
[picture p8: CAD file, 2026-11-09]
hardware/cad/freecad/TankMonitorMechanical.FCStd
260.0 x 120.0 x 150.0 mm
TrayMountHole3
PCBEnvelope
Standoff0
Standoff1
Standoff2
Standoff3
CageSuspension1
