Darksplat/solar-rainwater-tank-monitor/hardware/cad/step/BatteryShelf.step

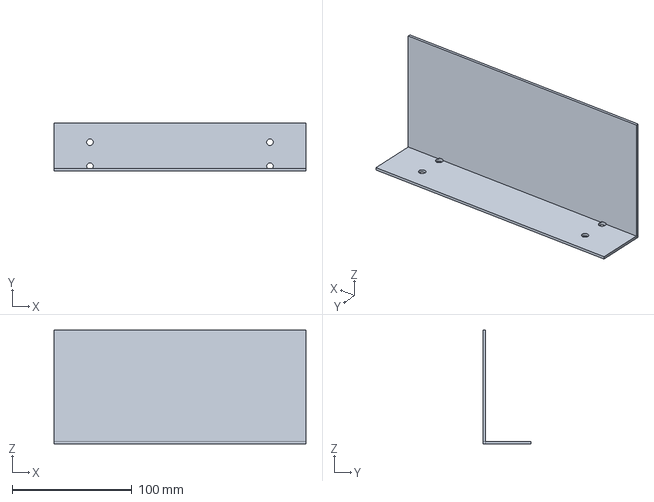
[picture p9: CAD file, 2026-11-09]
hardware/cad/step/BatteryShelf.step
210.0 x 40.0 x 95.0 mm
