Darksplat/solar-rainwater-tank-monitor/hardware/pcb/3d/tank-monitor-board.step

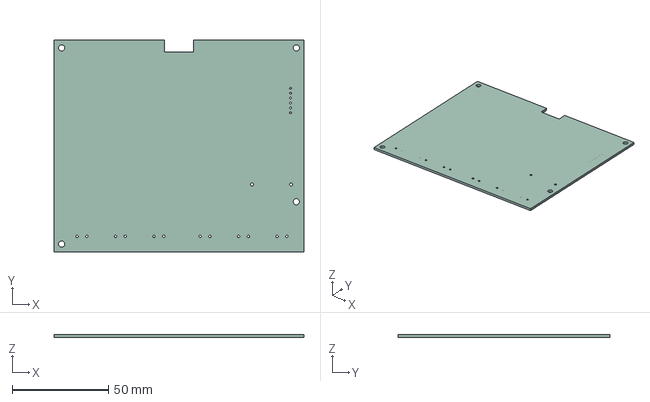
[picture p10: CAD file, 2026-11-09]
hardware/pcb/3d/tank-monitor-board.step
130.0 x 110.0 x 1.51 mm
