Darksplat/solar-rainwater-tank-monitor/hardware/cad/step/SupportArm1.step

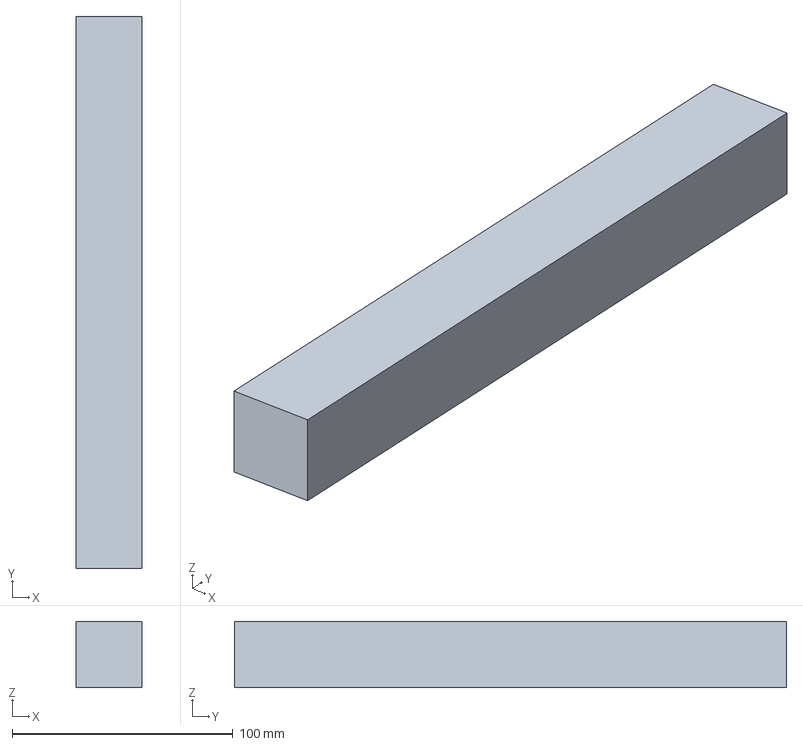
[picture p11: CAD file, 2026-11-09]
hardware/cad/step/SupportArm1.step
30.0 x 250.0 x 30.0 mm
