Darksplat/solar-rainwater-tank-monitor/hardware/cad/step/CableDuctEnvelope.step

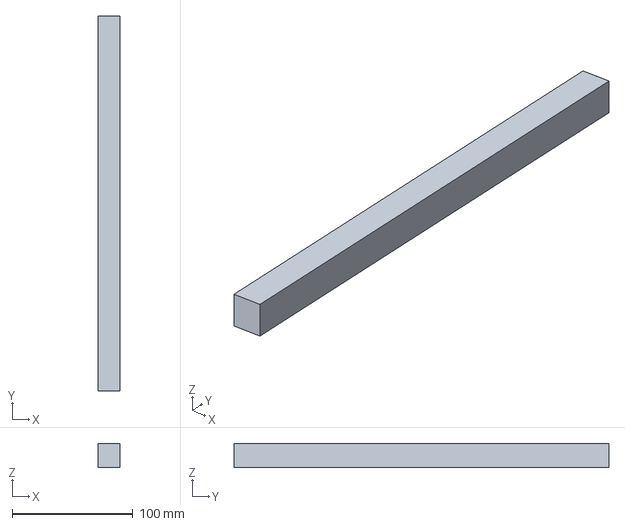
[picture p12: CAD file, 2026-11-09]
hardware/cad/step/CableDuctEnvelope.step
18.0 x 310.0 x 20.0 mm
