Darksplat/solar-rainwater-tank-monitor/hardware/cad/step/BatteryStrap1.step

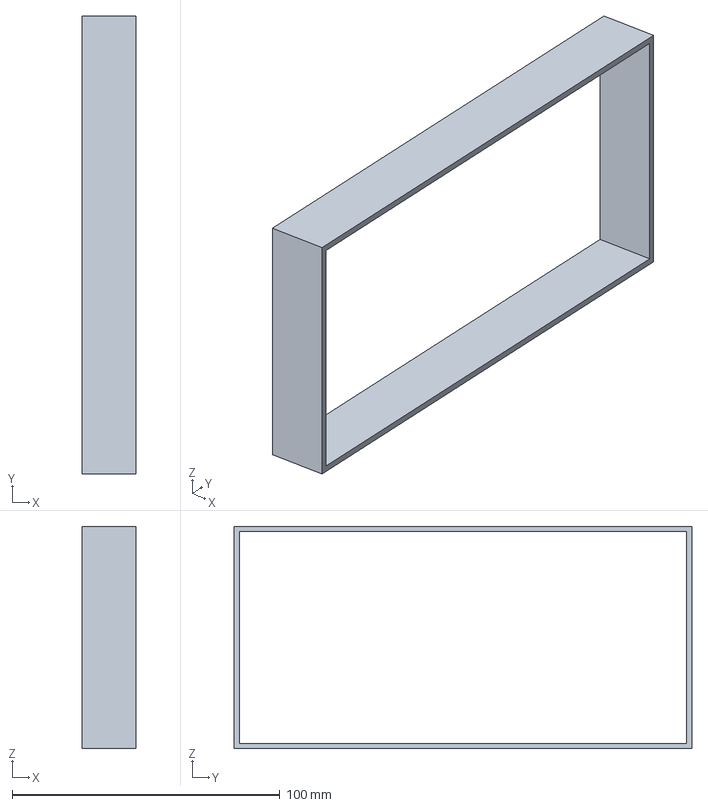
[picture p13: CAD file, 2026-11-09]
hardware/cad/step/BatteryStrap1.step
20.0 x 171.0 x 83.0 mm
