Darksplat/solar-rainwater-tank-monitor/hardware/cad/step/PostReference.step

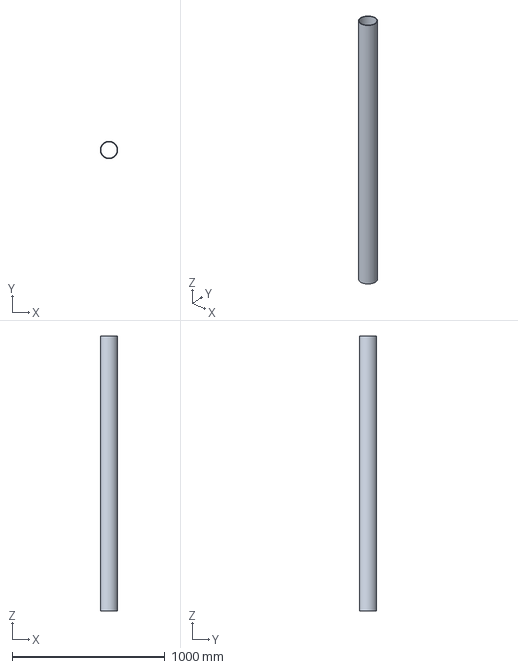
[picture p14: CAD file, 2026-11-09]
hardware/cad/step/PostReference.step
114.2 x 114.2 x 1800.0 mm
