Darksplat/solar-rainwater-tank-monitor/hardware/cad/step/BatteryTerminalServiceKeepout.step

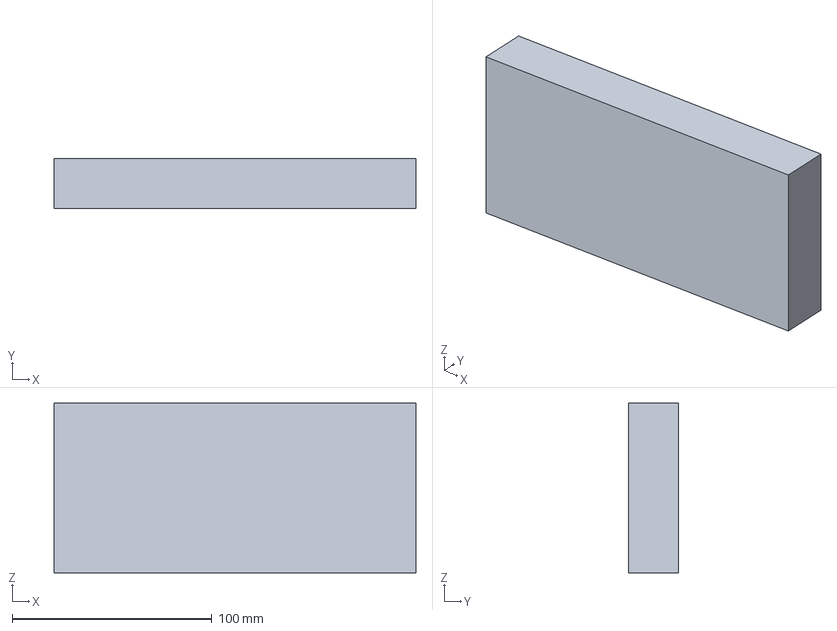
[picture p15: CAD file, 2026-11-09]
hardware/cad/step/BatteryTerminalServiceKeepout.step
181.0 x 25.0 x 85.0 mm
