Darksplat/solar-rainwater-tank-monitor/hardware/cad/step/SolarRail2.step

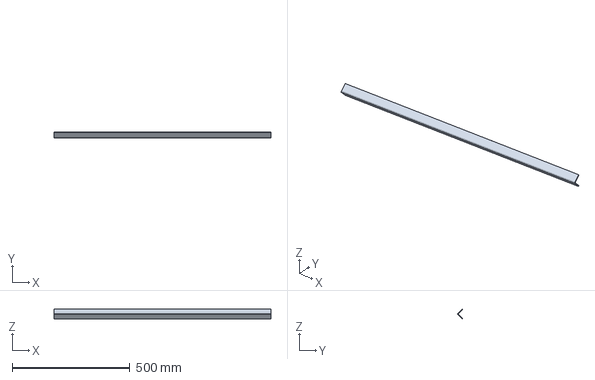
[picture p16: CAD file, 2026-11-09]
hardware/cad/step/SolarRail2.step
920.0 x 23.3 x 42.4 mm
