Darksplat/solar-rainwater-tank-monitor/hardware/cad/step/ServiceBackplate.step

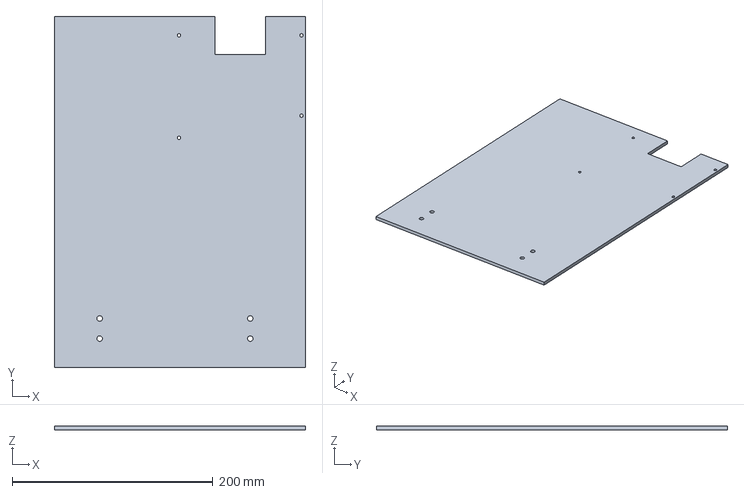
[picture p17: CAD file, 2026-11-09]
hardware/cad/step/ServiceBackplate.step
250.0 x 350.0 x 4.00 mm
