Darksplat/solar-rainwater-tank-monitor/hardware/cad/step/RackSpine2.step

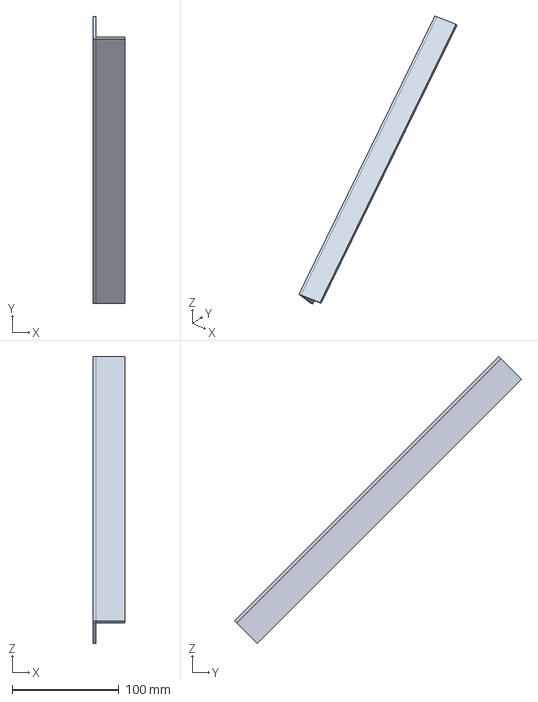
[picture p18: CAD file, 2026-11-09]
hardware/cad/step/RackSpine2.step
30.0 x 268.7 x 268.7 mm
