Darksplat/solar-rainwater-tank-monitor/hardware/cad/step/PanelReference2.step

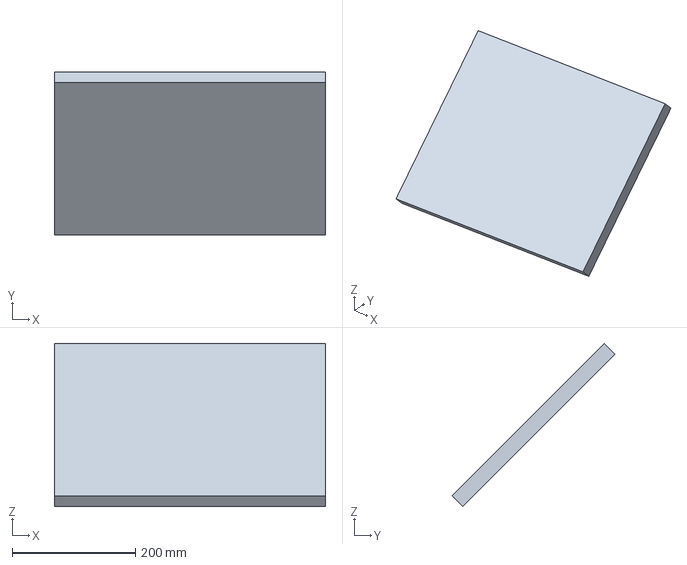
[picture p19: CAD file, 2026-11-09]
hardware/cad/step/PanelReference2.step
440.0 x 265.2 x 265.2 mm
