Darksplat/solar-rainwater-tank-monitor/hardware/cad/step/ChargerReference.step

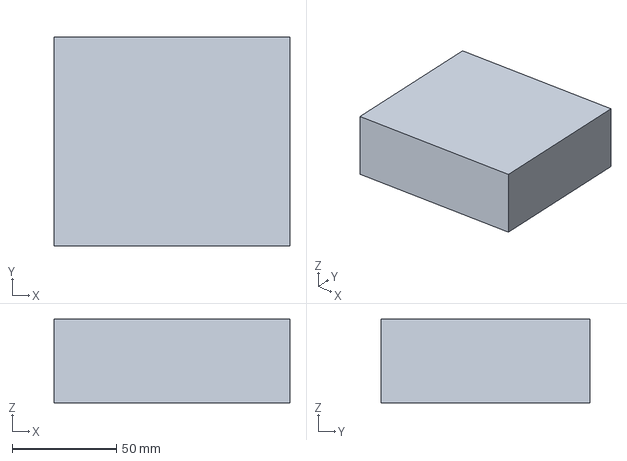
[picture p20: CAD file, 2026-11-09]
hardware/cad/step/ChargerReference.step
113.0 x 100.0 x 40.0 mm
