Darksplat/solar-rainwater-tank-monitor/hardware/cad/step/SolarPostMount.step

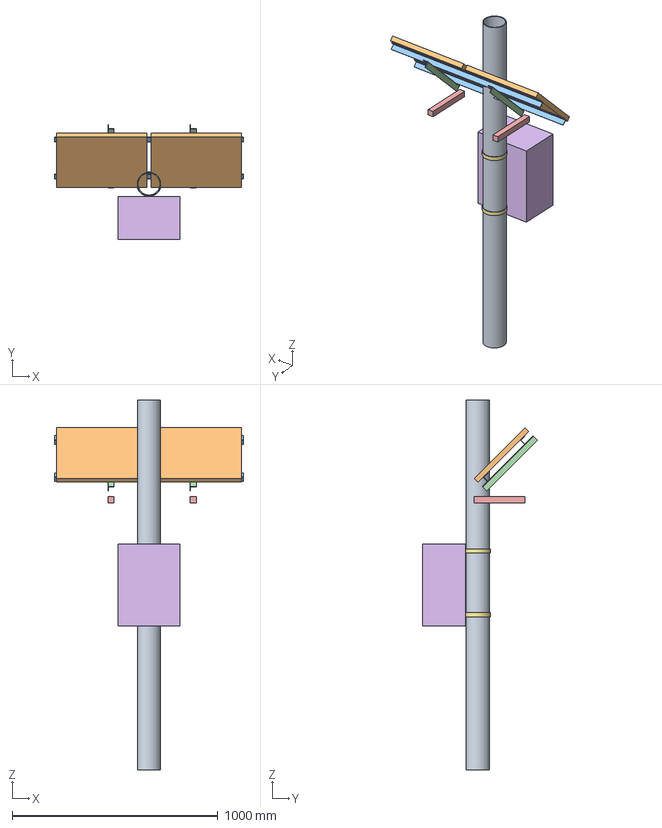
[picture p21: CAD file, 2026-11-09]
hardware/cad/step/SolarPostMount.step
920.0 x 559.9 x 1800.0 mm
