Darksplat/solar-rainwater-tank-monitor/hardware/cad/step/PCBSpacer2.step

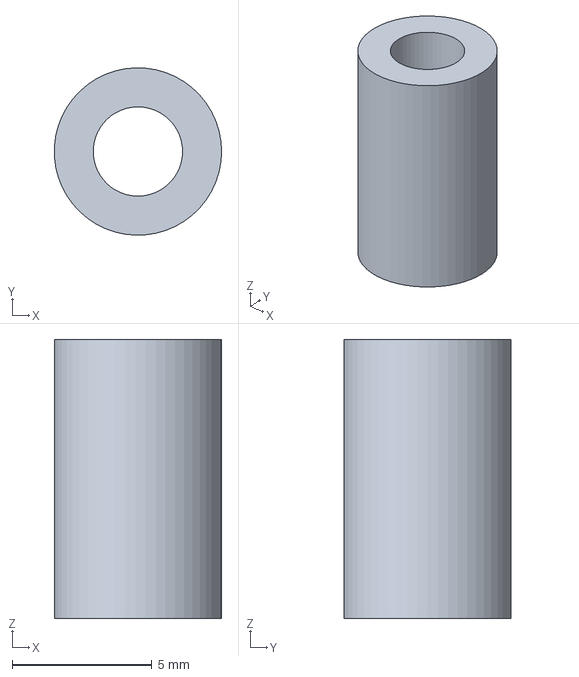
[picture p22: CAD file, 2026-11-09]
hardware/cad/step/PCBSpacer2.step
5.99 x 6.00 x 10.0 mm
