Darksplat/solar-rainwater-tank-monitor/hardware/cad/step/CabinetReference.step

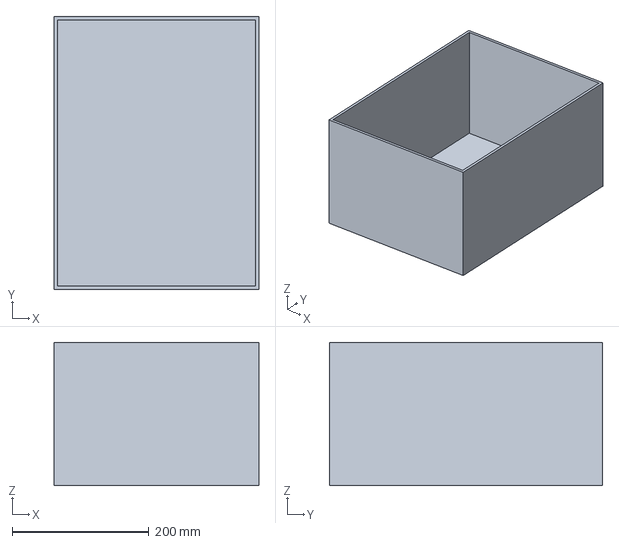
[picture p23: CAD file, 2026-11-09]
hardware/cad/step/CabinetReference.step
300.0 x 400.0 x 210.0 mm
