Darksplat/solar-rainwater-tank-monitor/hardware/cad/step/AntennaMetalKeepout.step

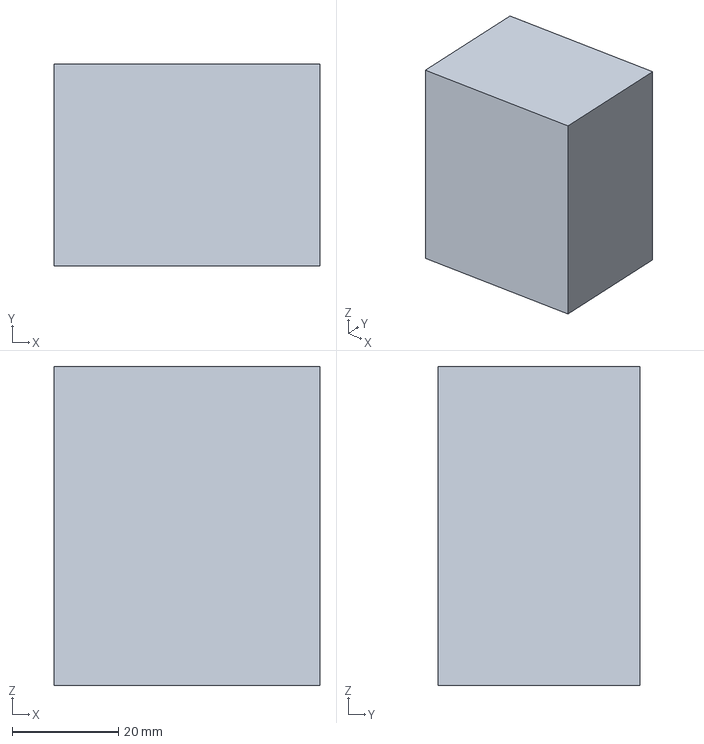
[picture p24: CAD file, 2026-11-09]
hardware/cad/step/AntennaMetalKeepout.step
50.0 x 38.0 x 60.0 mm
