Darksplat/solar-rainwater-tank-monitor/hardware/cad/step/BatteryProtectReference.step

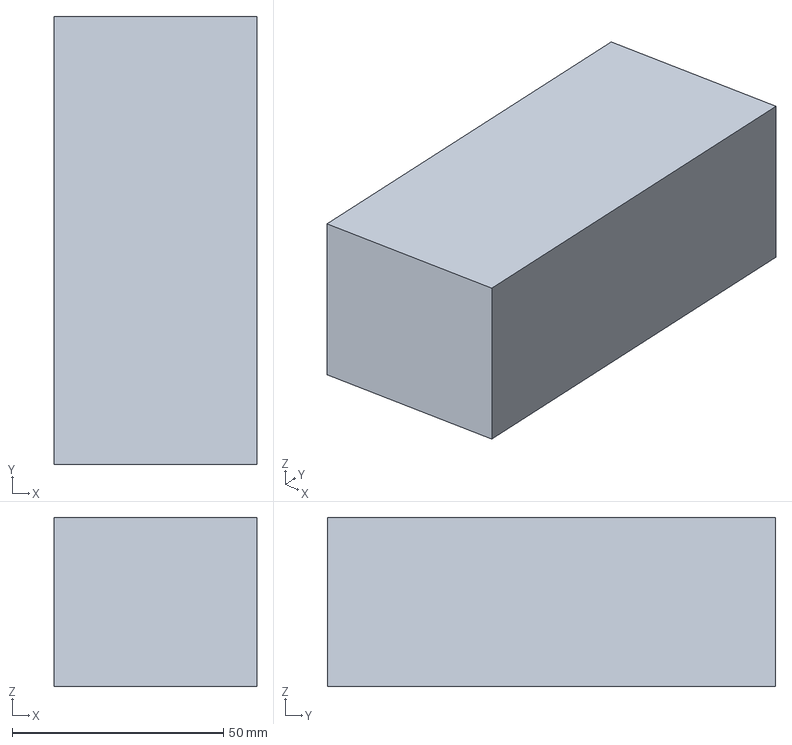
[picture p25: CAD file, 2026-11-09]
hardware/cad/step/BatteryProtectReference.step
48.0 x 106.0 x 40.0 mm
