Darksplat/solar-rainwater-tank-monitor/hardware/cad/step/PoleBandReference2.step

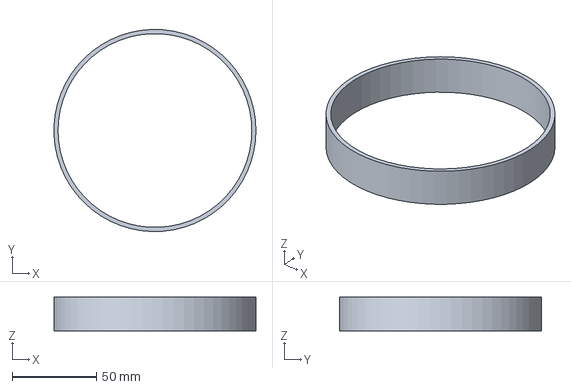
[picture p26: CAD file, 2026-11-09]
hardware/cad/step/PoleBandReference2.step
119.9 x 120.0 x 20.0 mm
