Darksplat/solar-rainwater-tank-monitor/hardware/cad/step/BatteryReference.step

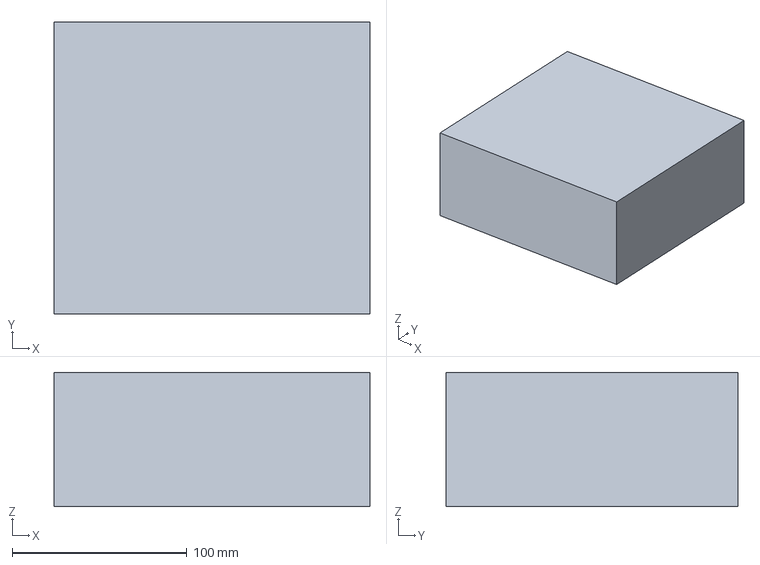
[picture p27: CAD file, 2026-11-09]
hardware/cad/step/BatteryReference.step
181.0 x 167.0 x 77.0 mm
