Darksplat/solar-rainwater-tank-monitor/hardware/cad/step/MountCabinetReference.step

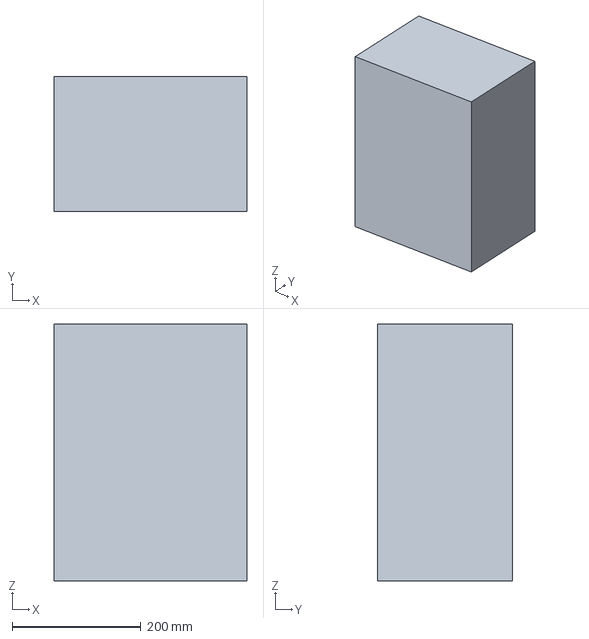
[picture p28: CAD file, 2026-11-09]
hardware/cad/step/MountCabinetReference.step
300.0 x 210.0 x 400.0 mm
