Darksplat/solar-rainwater-tank-monitor/hardware/cad/step/TankMonitorExploded.step

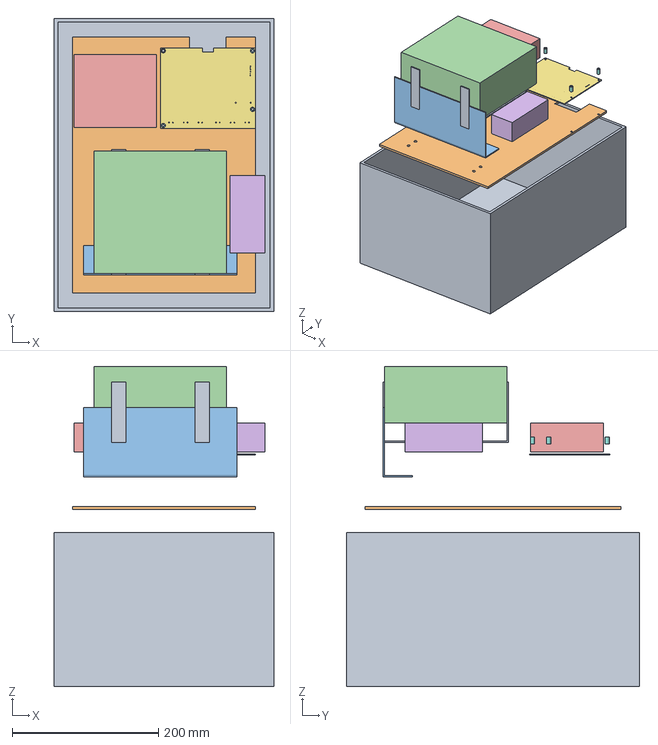
[picture p29: CAD file, 2026-11-09]
hardware/cad/step/TankMonitorExploded.step
300.0 x 400.0 x 437.0 mm
