Darksplat/solar-rainwater-tank-monitor/hardware/cad/step/CageSuspension1.step

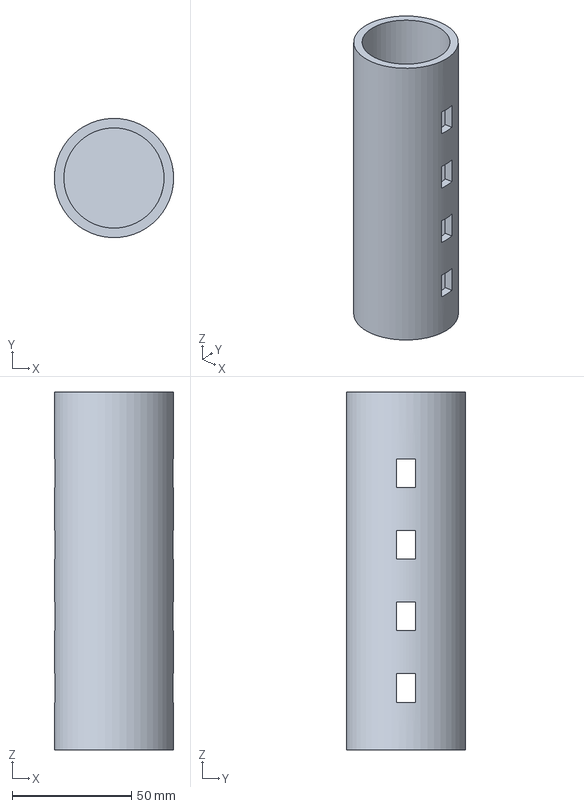
[picture p30: CAD file, 2026-11-09]
hardware/cad/step/CageSuspension1.step
50.0 x 50.0 x 150.0 mm
