Darksplat/solar-rainwater-tank-monitor/hardware/cad/step/Standoff0.step

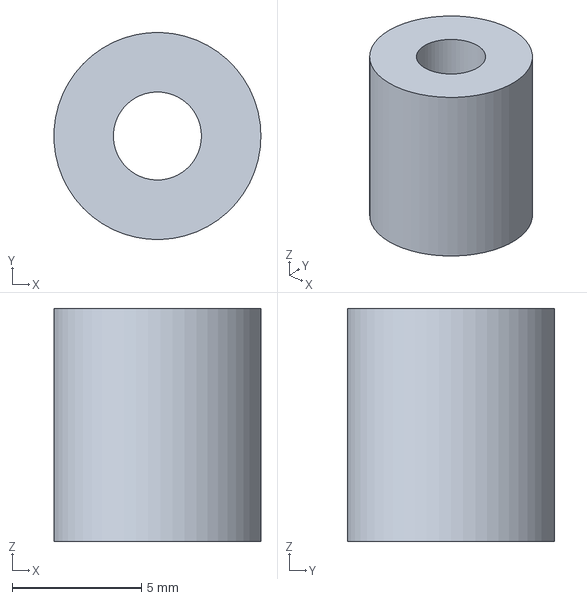
[picture p31: CAD file, 2026-11-09]
hardware/cad/step/Standoff0.step
7.99 x 8.00 x 9.00 mm
