Darksplat/solar-rainwater-tank-monitor/hardware/cad/step/TrayMountHole3.step

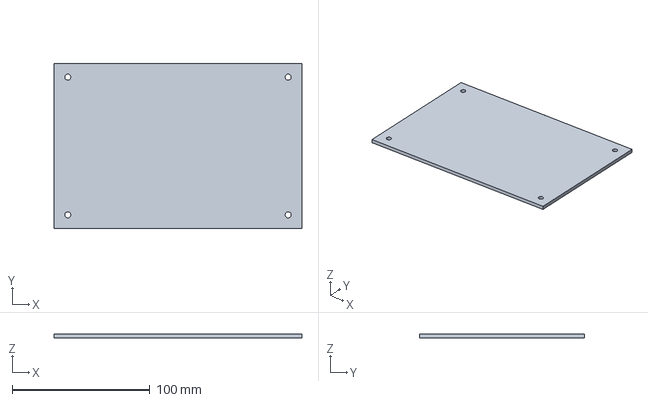
[picture p32: CAD file, 2026-11-09]
hardware/cad/step/TrayMountHole3.step
180.0 x 120.0 x 3.00 mm
