Darksplat/solar-rainwater-tank-monitor/hardware/cad/step/PCBEnvelope.step

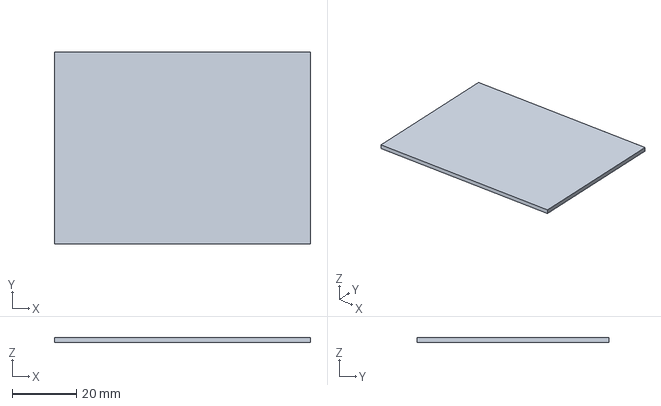
[picture p33: CAD file, 2026-11-09]
hardware/cad/step/PCBEnvelope.step
80.0 x 60.0 x 1.60 mm
