Darksplat/solar-rainwater-tank-monitor/(list of files, cad)

Other CAD files:
hardware/cad/step/SupportArm2.step
hardware/cad/step/RoutedPCB.step
hardware/cad/step/RackSpine1.step
hardware/cad/step/PCBSpacer4.step
hardware/cad/step/PCBSpacer3.step
hardware/cad/step/PanelReference1.step
hardware/cad/step/PCBSpacer1.step
hardware/cad/step/PoleBandReference1.step
hardware/cad/step/SolarRail1.step
hardware/cad/step/BatteryStrap2.step
hardware/cad/step/Standoff3.step
hardware/cad/step/Standoff2.step
hardware/cad/step/Standoff1.step
hardware/cad/freecad/SolarPostMount.FCStd
hardware/cad/freecad/TankMonitorAssembly.FCStd
hardware/cad/freecad/TankMonitorExploded.FCStd
hardware/cad/stl/AntennaMetalKeepout.stl
hardware/cad/stl/BatteryProtectReference.stl
hardware/cad/stl/BatteryReference.stl
hardware/cad/stl/BatteryShelf.stl
hardware/cad/stl/BatteryStrap1.stl
hardware/cad/stl/BatteryStrap2.stl
hardware/cad/stl/BatteryTerminalServiceKeepout.stl
hardware/cad/stl/CabinetReference.stl
hardware/cad/stl/CableDuctEnvelope.stl
hardware/cad/stl/CageSuspension1.stl
hardware/cad/stl/ChargerReference.stl
hardware/cad/stl/MountCabinetReference.stl
hardware/cad/stl/PCBEnvelope.stl
hardware/cad/stl/PCBSpacer1.stl
hardware/cad/stl/PCBSpacer2.stl
hardware/cad/stl/PCBSpacer3.stl
hardware/cad/stl/PCBSpacer4.stl
hardware/cad/stl/PanelReference1.stl
hardware/cad/stl/PanelReference2.stl
hardware/cad/stl/PoleBandReference1.stl
hardware/cad/stl/PoleBandReference2.stl
hardware/cad/stl/PostReference.stl
hardware/cad/stl/RackSpine1.stl
hardware/cad/stl/RackSpine2.stl
hardware/cad/stl/RoutedPCB.stl
hardware/cad/stl/ServiceBackplate.stl
hardware/cad/stl/SolarRail1.stl
hardware/cad/stl/SolarRail2.stl
hardware/cad/stl/Standoff0.stl
hardware/cad/stl/Standoff1.stl
hardware/cad/stl/Standoff2.stl
hardware/cad/stl/Standoff3.stl
hardware/cad/stl/SupportArm1.stl
hardware/cad/stl/SupportArm2.stl
hardware/cad/stl/TrayMountHole3.stl
