Darksplat/solar-rainwater-tank-monitor/CHANGELOG.md

# Changelog

## 0.2.0-dev — 2026-11-09

- Replace preliminary ADS1115 interface with protected high-side INA228 loop, battery and PV measurements.
- Add 83-component schematic, four-layer routed PCB with dedicated shunt sense branches, zero-violation ERC/DRC evidence, fabrication exports and source/export audits.
- Implement real-driver I²C fault handling, verified-reference coulomb SOC, voltage guards, status LED, Thread telemetry and HA power alerts.
- Add measured-source regional NASA solar data and full standby/aging/cold design allowances.
- Add editable cabinet packaging, exploded assembly, actual PCB body and solar/post mounting studies with saved geometry checks.
- Add assembly, sourcing and revised installation documentation; procurement and physical qualification remain open.
- Test binaries use public fixtures and are incompatible with revision0.1 hardware. No production approval or physical acceptance.

## 0.1.0-dev — 2026-11-09
Research evidence, conservative power model, shared calculation core, tests and ESPHome prototype. No production release.
