Darksplat/solar-rainwater-tank-monitor/hardware/pcb/layout/tank-monitor.kicad_pcb

## KiCad design hardware/pcb/layout/tank-monitor.kicad_pcb (2026-11-09)

Schematic: tank-monitor.kicad_sch, Solar tank monitor - Rev 0.2 engineering schematic

Parts:
C1: 10u 50V X7R; C_1210_3225Metric; MPN C3225X7R1H106K250AC
C2: 100n 50V; C_0603_1608Metric; MPN C1608X7R1H104K080AA
C3: 100n 16V; C_0603_1608Metric; MPN C1608X7R1H104K080AA
C4, C5: 22u 16V X7R; C_1210_3225Metric; MPN C3225X7R1C226M250AC
C6: 4.7u 16V X7R; C_0805_2012Metric; MPN C2012X7R1C475K125AB
C7: 4.7u 50V X7R; C_1210_3225Metric; MPN C3225X7R1H475K250AB
C8: 10n; C_0603_1608Metric; MPN C1608X7R1H103K080AA
C20, C30, C40: 100n 100V; C_0805_2012Metric; MPN C2012X7R2A104K125AA
C21, C31, C41, C52: 100n; C_0603_1608Metric; MPN C1608X7R1H104K080AA
C50: 1u; C_0603_1608Metric; MPN C1608X7R1C105K080AC
C51: 10u 35V X5R; C_0805_2012Metric; MPN C2012X5R1V106K085AC
D1, D3: B360A-13-F; D_SMA; MPN B360A-13-F
D2: SMBJ15A; D_SMB; MPN SMBJ15A
D4: SMBJ18A; D_SMB; MPN SMBJ18A
D5, D6, D7: SMBJ51A; D_SMB; MPN SMBJ51A
D8: STATUS; LED_0603_1608Metric; MPN LTST-C190KGKT
D9: 1N5408; 1N5408_DO201AD_P20.32; MPN 1N5408-E3/54
D10: 1N4148W-7-F; D_SOD-123; MPN 1N4148W-7-F
J1: BATTERY FUSED 5A; TerminalBlock_Phoenix_MKDS-1,5-2-5.08_1x02_P5.08mm_Horizont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; MPN Phoenix 1715721
J2: CHARGER BAT; TerminalBlock_Phoenix_MKDS-1,5-2-5.08_1x02_P5.08mm_Horizont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; MPN Phoenix 1715721
J3: PROTECTED LOAD; TerminalBlock_Phoenix_MKDS-1,5-2-5.08_1x02_P5.08mm_Horizont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; MPN Phoenix 1715721
J4: PV INPUT; TerminalBlock_Phoenix_MKDS-1,5-2-5.08_1x02_P5.08mm_Horizont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; MPN Phoenix 1715721
J5: CHARGER PV; TerminalBlock_Phoenix_MKDS-1,5-2-5.08_1x02_P5.08mm_Horizont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; MPN Phoenix 1715721
J6: PRESSURE LOOP; TerminalBlock_Phoenix_MKDS-1,5-2-5.08_1x02_P5.08mm_Horizont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; MPN Phoenix 1715721
J7: UART 3.3V ONLY; PinHeader_1x06_P2.54mm_Vertical; MPN TSW-106-07-G-S
L1: 4.7uH Isat>=4A; L_Bourns_SRP5030T; MPN SRP5030TA-4R7M
L2: 10uH Isat>=1.6A; L_Bourns_SRP5030T; MPN SRP5030TA-100M
Q1: DMP2035U-7; SOT-23; MPN DMP2035U-7
Q2, Q3: IPD50N06S4L-12; TO-252-2; MPN IPD50N06S4L12ATMA2
Q4: BC847B-7-F; SOT-23; MPN BC847B-7-F
R1: 0.01R 1% 1W; R_2512_6332Metric; MPN WSL2512R0100FEA
R2: 0.02R 1% 1W; R_2512_6332Metric; MPN WSL2512R0200FEA
R3, R4, R5, R10, R65, R66: 100k; R_0603_1608Metric; MPN RC0603FR-07100KL
R6: 1k; R_0603_1608Metric; MPN RC0603FR-071KL
R7: 130k 0.1%; R_0603_1608Metric; MPN RT0603BRD07130KL
R8: 10k 0.1%; R_0603_1608Metric; MPN RT0603BRD0710KL
R9: 4.99k; R_0603_1608Metric; MPN RC0603FR-074K99L
R11: 2R 0.1% 25ppm; R_1206_3216Metric; MPN RT1206BRD072RL
R12, R13: 110R 1.5W; R_2512_6332Metric; MPN CRCW2512110RFKEGHP
R20, R21, R22, R40, R41, R42: 10R; R_0603_1608Metric; MPN RC0603FR-0710RL
R30, R31, R32: 47R; R_0603_1608Metric; MPN RC0603FR-0747RL
R50, R51: 4.7k; R_0603_1608Metric; MPN RC0603FR-074K7L
R52, R53, R54, R64, R67: 10k; R_0603_1608Metric; MPN RC0603FR-0710KL
R55: 2.2k; R_0603_1608Metric; MPN RC0603FR-072K2L
R60: 2.74M; R_0603_1608Metric; MPN RC0603FR-072M74L
R61: 215k; R_0603_1608Metric; MPN RC0603FR-07215KL
R62: 84.5k; R_0603_1608Metric; MPN RC0603FR-0784K5L
R63: 510k; R_0603_1608Metric; MPN RC0603FR-07510KL
SW1: RESET; SW_SPST_TL3342; MPN TL3342F160QG-TR
SW2: BOOT; SW_SPST_TL3342; MPN TL3342F160QG-TR
TP1: GND; TestPoint_Pad_D2.0mm
TP2: V3V3; TestPoint_Pad_D2.0mm
TP3: VIN; TestPoint_Pad_D2.0mm
TP4: LOOP_SUPPLY; TestPoint_Pad_D2.0mm
TP5: LOOP_P; TestPoint_Pad_D2.0mm
TP6: SDA; TestPoint_Pad_D2.0mm
TP7: SCL; TestPoint_Pad_D2.0mm
TP8: BAT_FUSED; TestPoint_Pad_D2.0mm
TP9: CHARGER_BAT; TestPoint_Pad_D2.0mm
TP10: PV_IN; TestPoint_Pad_D2.0mm
TP11: PV_OUT; TestPoint_Pad_D2.0mm
TP12: LOOP_EN_N; TestPoint_Pad_D2.0mm
U1: AP63203WU-7; TSOT-23-6; MPN AP63203WU-7
U2: TPS61170DRVR; WSON-6-1EP_2x2mm_P0.65mm_EP1x1.6mm; MPN TPS61170DRVR
U3, U4, U5: INA228AIDGSR; TSSOP-10_3x3mm_P0.5mm; MPN INA228AIDGSR
U6: ESP32-C6-MINI-1-N4; ESP32-C6-MINI-1-edge-silk; MPN ESP32-C6-MINI-1-N4
U7: LTC4365ITS8#TRMPBF; TSOT-23-8; MPN LTC4365ITS8#TRMPBF

Connections:
BAT_FUSED: Q3.2 (D), R1.1, R20.1, R22.1, TP8.1, U7.7 (Vout)
BAT_N: C20.2, R21.2, U3.9 (Vin-)
BAT_P: C20.1, R20.2, U3.10 (Vin+)
BAT_RAW: J1.1, Q2.2 (D), R60.1, R63.1, R65.1, U7.1 (Vin)
BAT_VBUS: R22.2, U3.8 (Vbus)
BOOST_GATE: Q1.1 (G), R5.1, R6.2
BOOST_IN: C6.1, L2.1, Q1.3 (D), U2.5 (CTRL), U2.6 (VIN)
BOOT: J7.5, R53.2, SW2.1, U6.23 (IO9)
BST: C3.1, U1.6 (BST)
CHARGER_BAT: J2.1, R1.2, R21.1, TP9.1
COMP: R9.1, U2.2 (COMP)
COMP_RC: C8.1, R9.2
EN: C50.1, J7.6, R52.2, SW1.1, U6.8 (EN)
EN_BUCK: R3.2, R4.1, U1.2 (EN)
FB_BOOST: R7.2, R8.1, U2.1 (FB)
GND: C1.2, C2.2, C4.2, C5.2, C6.2, C7.2, C8.2, C21.2, C31.2, C41.2, C50.2, C51.2, C52.2, D2.2 (A), D4.2 (A), D5.2 (A), D6.2 (A), D7.2 (A), D10.2 (A), J1.2, J2.2, J3.2, J6.2, J7.1, Q4.2 (E), R4.2, R8.2, R10.2, R62.2, R67.2, SW1.2, SW2.2, TP1.1, U1.4 (GND), U2.3 (GND), U2.7 (PAD), U3.1 (A1), U3.2 (A0), U3.7 (GND), U4.1 (A1), U4.7 (GND), U5.1 (A1), U5.7 (GND), U6.1 (GND), U6.2 (GND), U6.11 (GND), U6.14 (GND), U6.36 (GND), U6.37 (GND), U6.38 (GND), U6.39 (GND), U6.40 (GND), U6.41 (GND), U6.42 (GND), U6.43 (GND), U6.44 (GND), U6.45 (GND), U6.46 (GND), U6.47 (GND), U6.48 (GND), U6.49 (GND), U6.50 (GND), U6.51 (GND), U6.52 (GND), U6.53 (GND), U7.4 (GND)
LED_A: D8.2 (A), R55.2
LED_K: D8.1 (K), U6.24 (IO18)
LOAD_IN: D1.2 (A), J3.1
LOOP_EN_N: R6.1, TP12.1, U6.9 (IO4)
LOOP_LIMIT_MID: R12.2, R13.1
LOOP_N: C40.2, R41.2, U5.9 (Vin-)
LOOP_P: C40.1, J6.1, R13.2, R40.2, R42.1, TP5.1, U5.10 (Vin+)
LOOP_SHUNT_OUT: R11.2, R12.1, R41.1
LOOP_SUPPLY: C7.1, D3.1 (K), D4.1 (K), R7.1, R10.1, R11.1, R40.1, TP4.1
LOOP_VBUS: R42.2, U5.8 (Vbus)
PV_IN: D9.1 (K), R2.1, R30.1, TP10.1
PV_N: C30.2, D6.1 (K), R31.2, U4.9 (Vin-)
PV_NEG: J4.2, J5.2
PV_OUT: J5.1, R2.2, R31.1, R32.1, TP11.1
PV_P: C30.1, D5.1 (K), R30.2, U4.10 (Vin+)
PV_RAW: D9.2 (A), J4.1
PV_VBUS: D7.1 (K), R32.2, U4.8 (Vbus)
RAW_BASE: D10.1 (K), Q4.1 (B), R65.2, R67.1
RAW_PRESENT: Q4.3 (C), R66.2, U6.26 (IO20)
REV_FAULT: R64.2, U6.25 (IO19), U7.6 (~FAULT)
REV_GATE: Q2.1 (G), Q3.1 (G), U7.8 (GATE)
REV_OV: R61.2, R62.1, U7.3 (OV)
REV_SHDN: R63.2, U7.5 (~SHDN)
REV_SOURCE: Q2.3 (S), Q3.3 (S)
REV_UV: R60.2, R61.1, U7.2 (UV)
RXD: J7.4, U6.30 (RXD0)
SCL: R51.2, TP7.1, U3.5 (SCL), U4.5 (SCL), U5.5 (SCL), U6.16 (IO7)
SDA: R50.2, TP6.1, U3.4 (SDA), U4.4 (SDA), U5.2 (A0), U5.4 (SDA), U6.15 (IO6)
STRAP8: R54.2, U6.22 (IO8)
SW_BOOST: D3.2 (A), L2.2, U2.4 (SW)
SW_BUCK: C3.2, L1.1, U1.5 (SW)
TXD: J7.3, U6.31 (TXD0)
V3V3: C4.1, C5.1, C21.1, C31.1, C41.1, C51.1, C52.1, J7.2, L1.2, Q1.2 (S), R5.2, R50.1, R51.1, R52.1, R53.1, R54.1, R55.1, R64.1, R66.1, TP2.1, U1.1 (FB), U3.6 (VS), U4.2 (A0), U4.6 (VS), U5.6 (VS), U6.3 (3V3)
VIN: C1.1, C2.1, D1.1 (K), D2.1 (K), R3.1, TP3.1, U1.3 (IN)

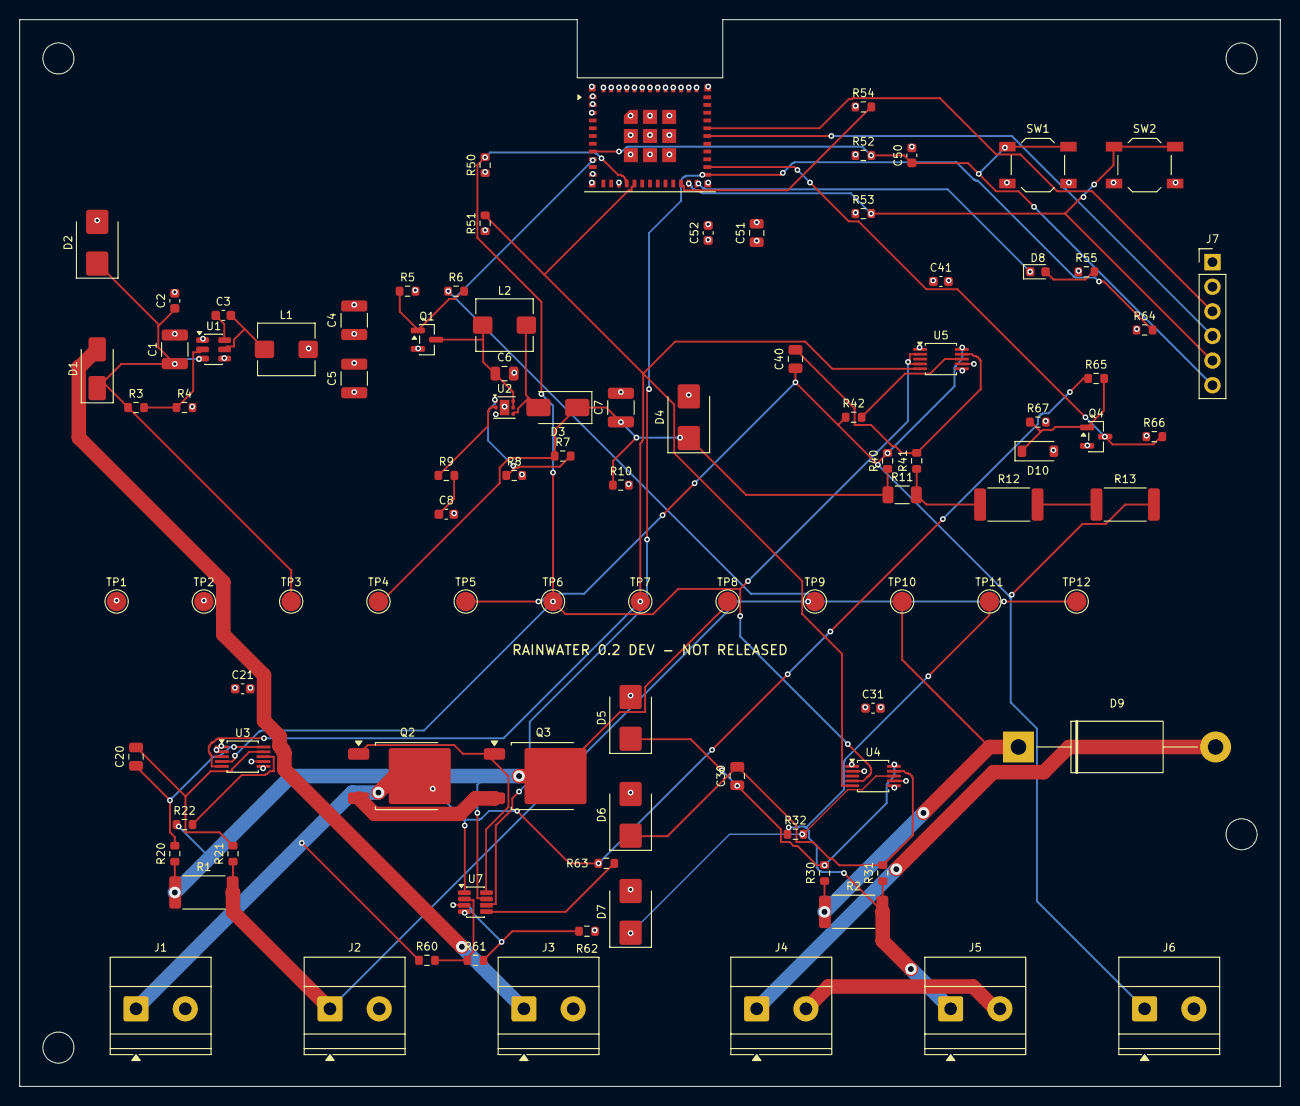
[picture p36: board tank-monitor.kicad_pcb from above]

Board: 4 copper layers, 130.0 x 110.0 mm, 101 parts (0 on the bottom side), 50 nets.

Other parts of the board:
H1, H2, H3, H4: MountingHole_3.2mm_M3
