Darksplat/solar-rainwater-tank-monitor/tools/fetch_solar_data.py

"""Fetch primary NASA POWER data at an approximate locality centroid, not a home address."""
from pathlib import Path
import urllib.request,json,datetime
p=Path(__file__).resolve().parents[1]
url='https://power.larc.nasa.gov/api/temporal/climatology/point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'
with urllib.request.urlopen(url,timeout=45) as r:data=json.load(r)
assert 'properties' in data,data
(p/'docs/data/nasa-power-climatology.json').write_text(json.dumps({'request_url':url,'locality':'Approximate Maiden Gully locality centroid; not a site measurement','retrieved_date':'2026-11-09','response':data},indent=2))
print(json.dumps(data['properties']['parameter'],indent=2))
