Darksplat/solar-rainwater-tank-monitor/(commit log)

2026-11-09 Add dual-tank development prototype with compiled firmware and test evidence
    [CageSuspension1.step, CageSuspension1.stl, PCBEnvelope.step, PCBEnvelope.stl, Standoff0.step, Standoff0.stl, Standoff1.step, Standoff1.stl]
2026-11-09 Complete revision 0.2 engineering package with input protection and owner tank configuration
    [AntennaMetalKeepout.step, AntennaMetalKeepout.stl, BatteryProtectReference.step, BatteryProtectReference.stl, BatteryReference.step, BatteryReference.stl, BatteryShelf.step, BatteryShelf.stl]
2026-11-11 Withdraw revision 0.2 fabrication exports after pressure sense net review
